Ivailo2707/Multiboard/README.md

# Multiboard
Multifunctional PCB with microcontroller and FPGA for embedded systems development
