Ivailo2707/Multiboard/Multiboard/Multiboard.kicad_pcb

## KiCad design Multiboard/Multiboard.kicad_pcb (2026-04-07)

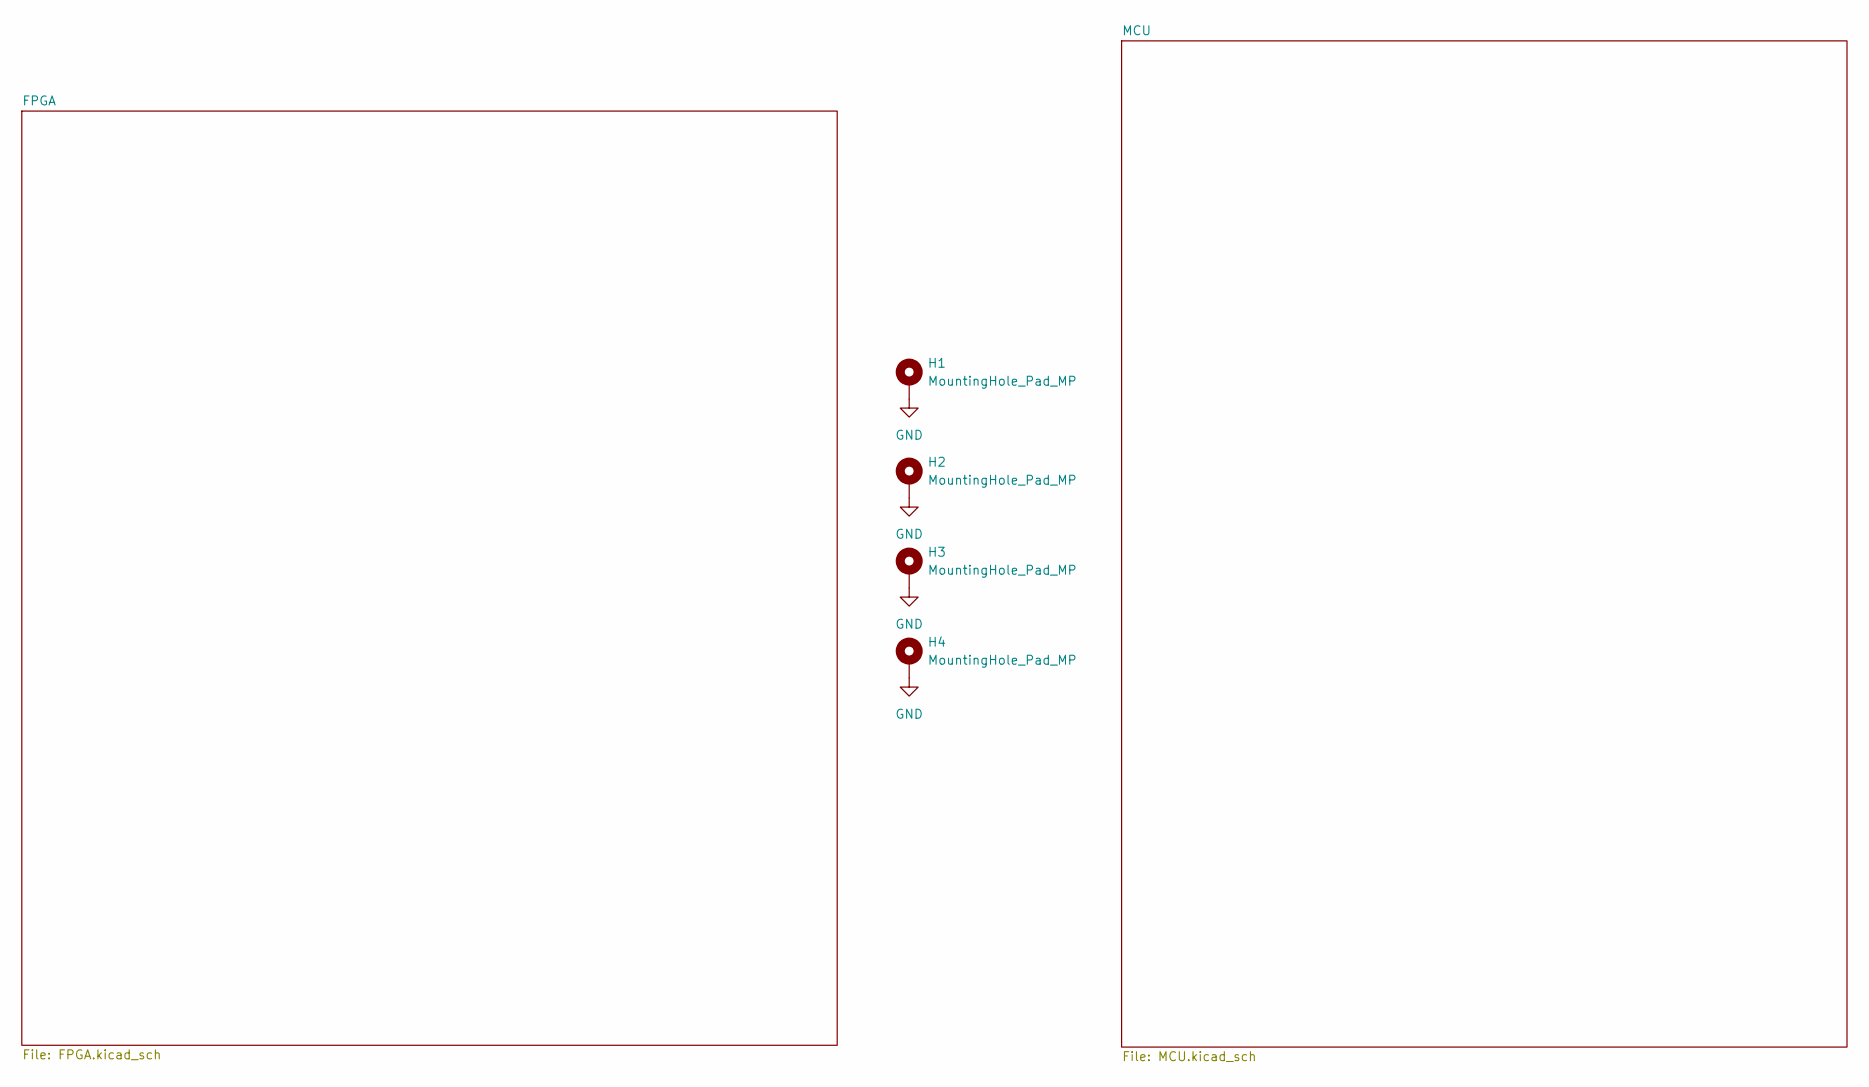
[picture p1: schematic Multiboard.kicad_sch, IR-Multiboard]

Parts:
H1, H2, H3, H4: MountingHole_Pad_MP; MountingHole_3.2mm_M3_DIN965_Pad_TopBottom

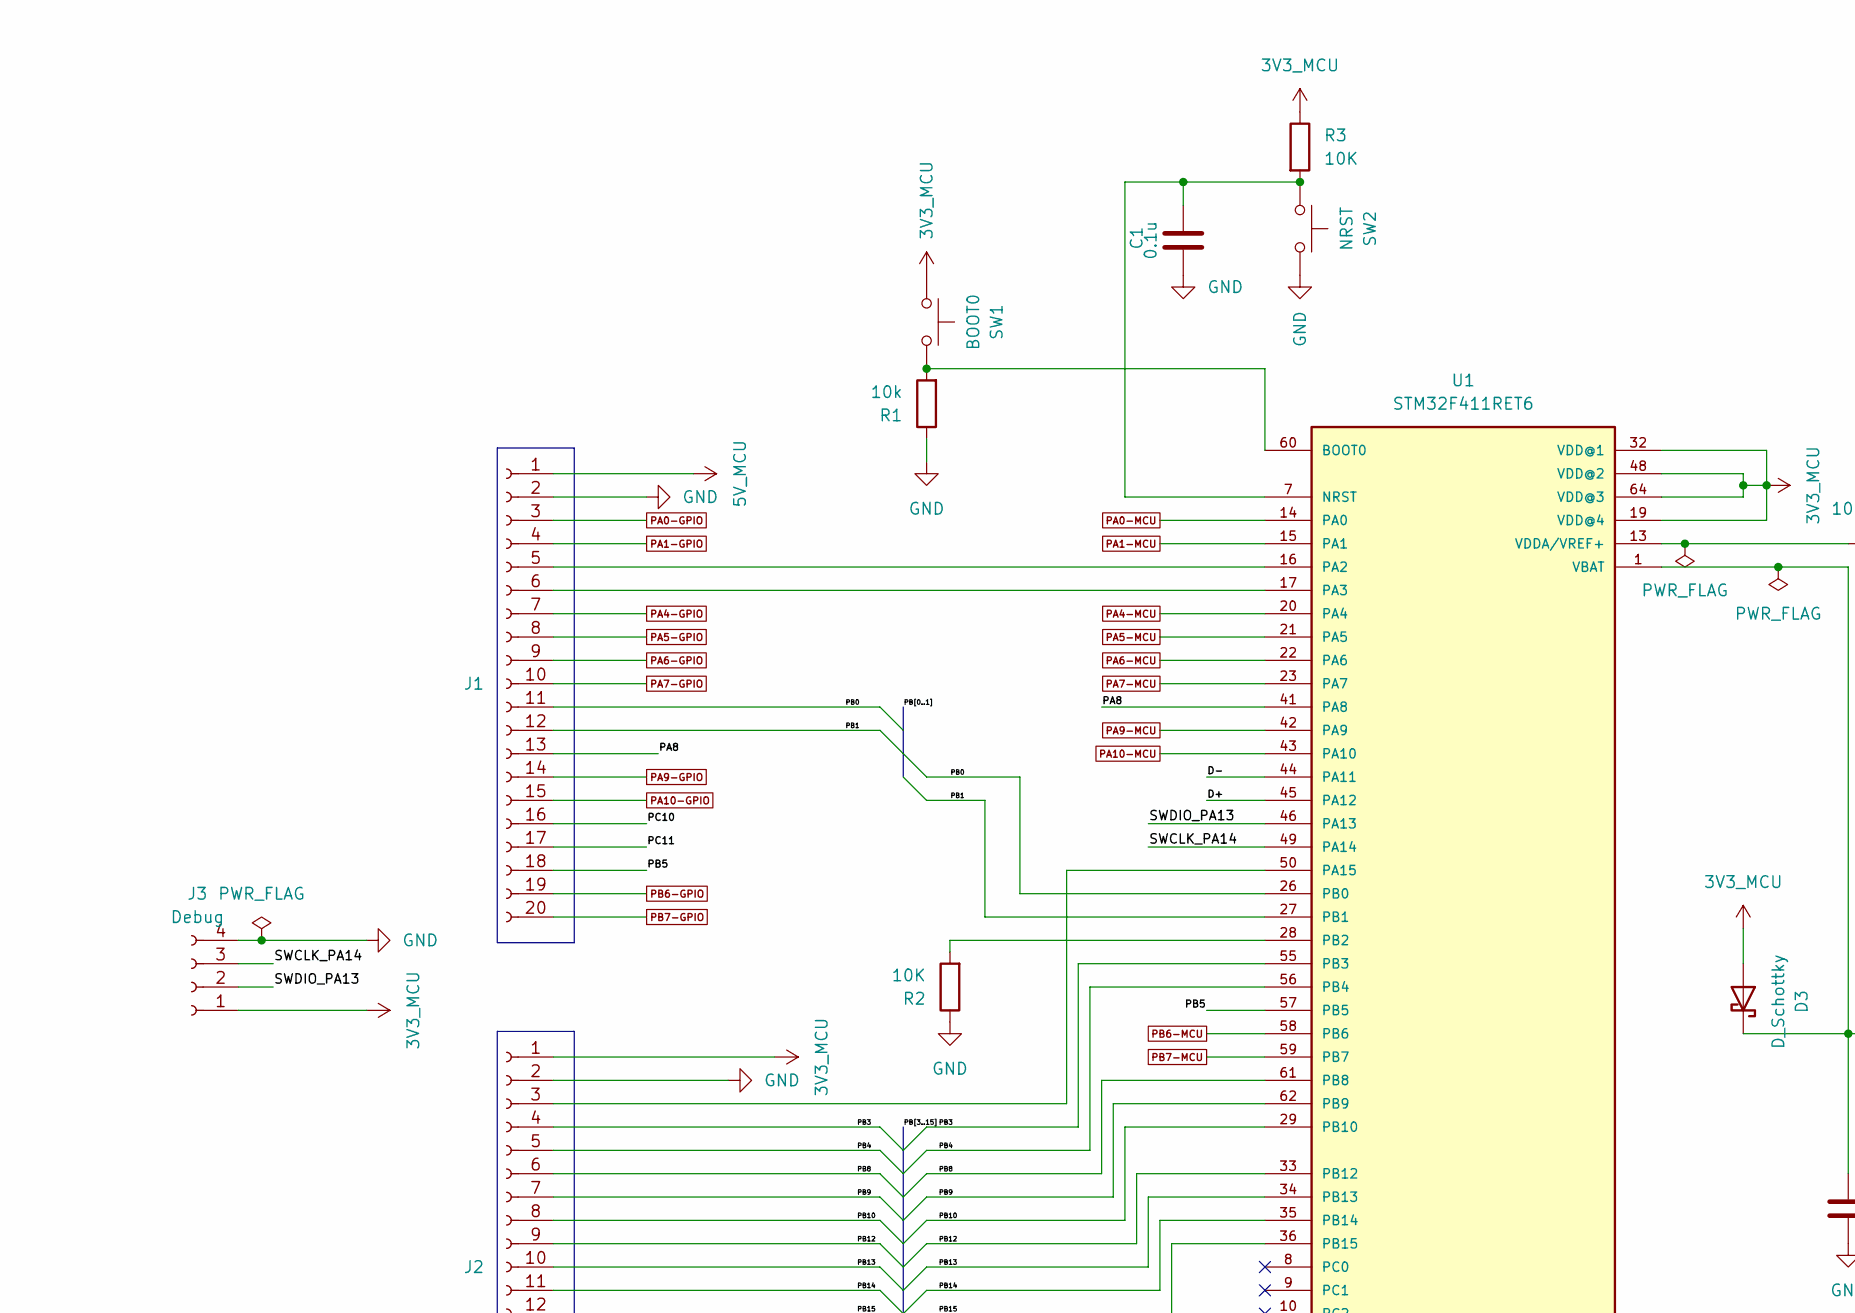
[picture p2: schematic MCU.kicad_sch, part in row 1, column 1]

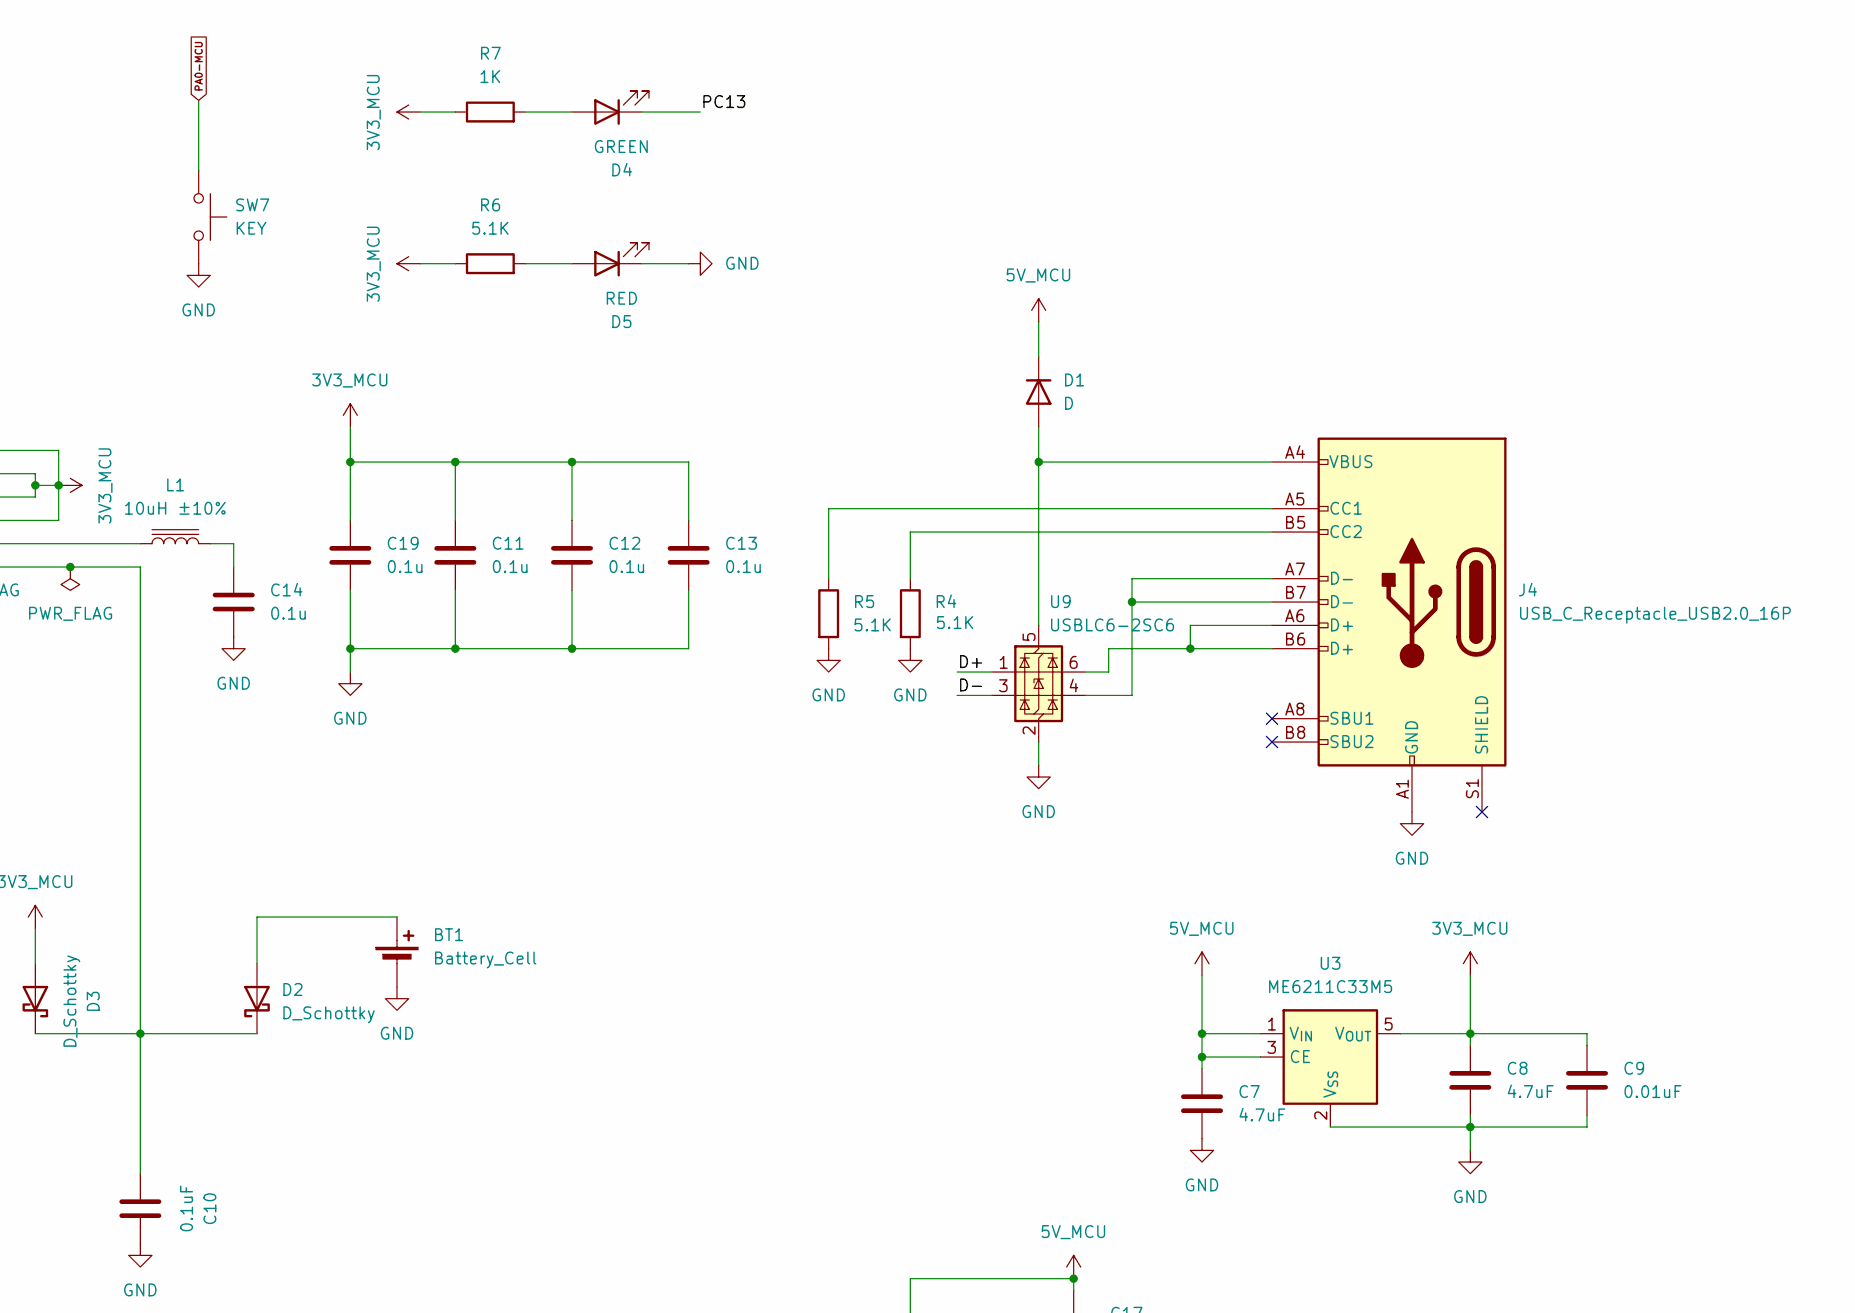
[picture p3: schematic MCU.kicad_sch, part in row 1, column 2]

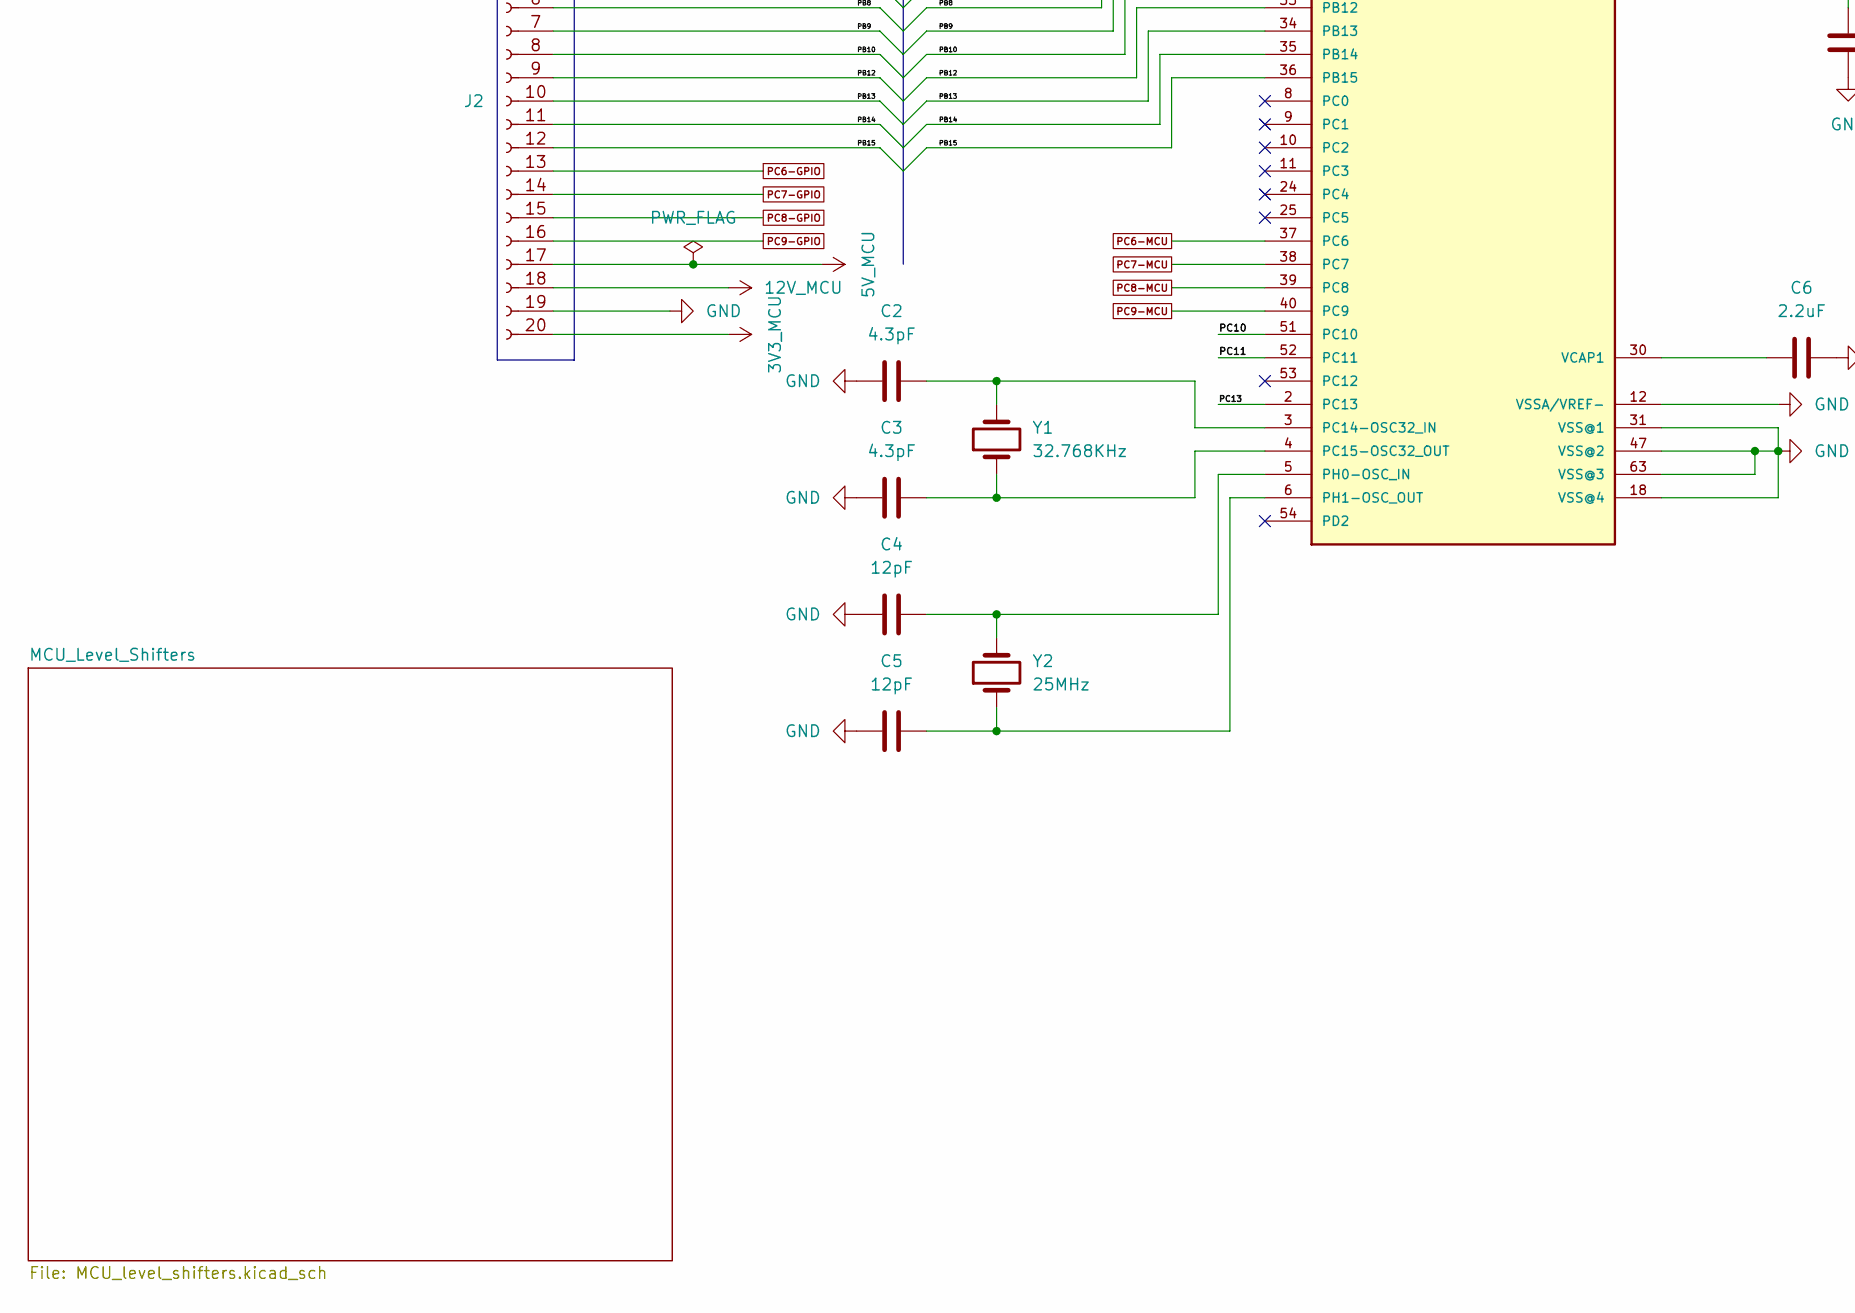
[picture p4: schematic MCU.kicad_sch, part in row 2, column 1]

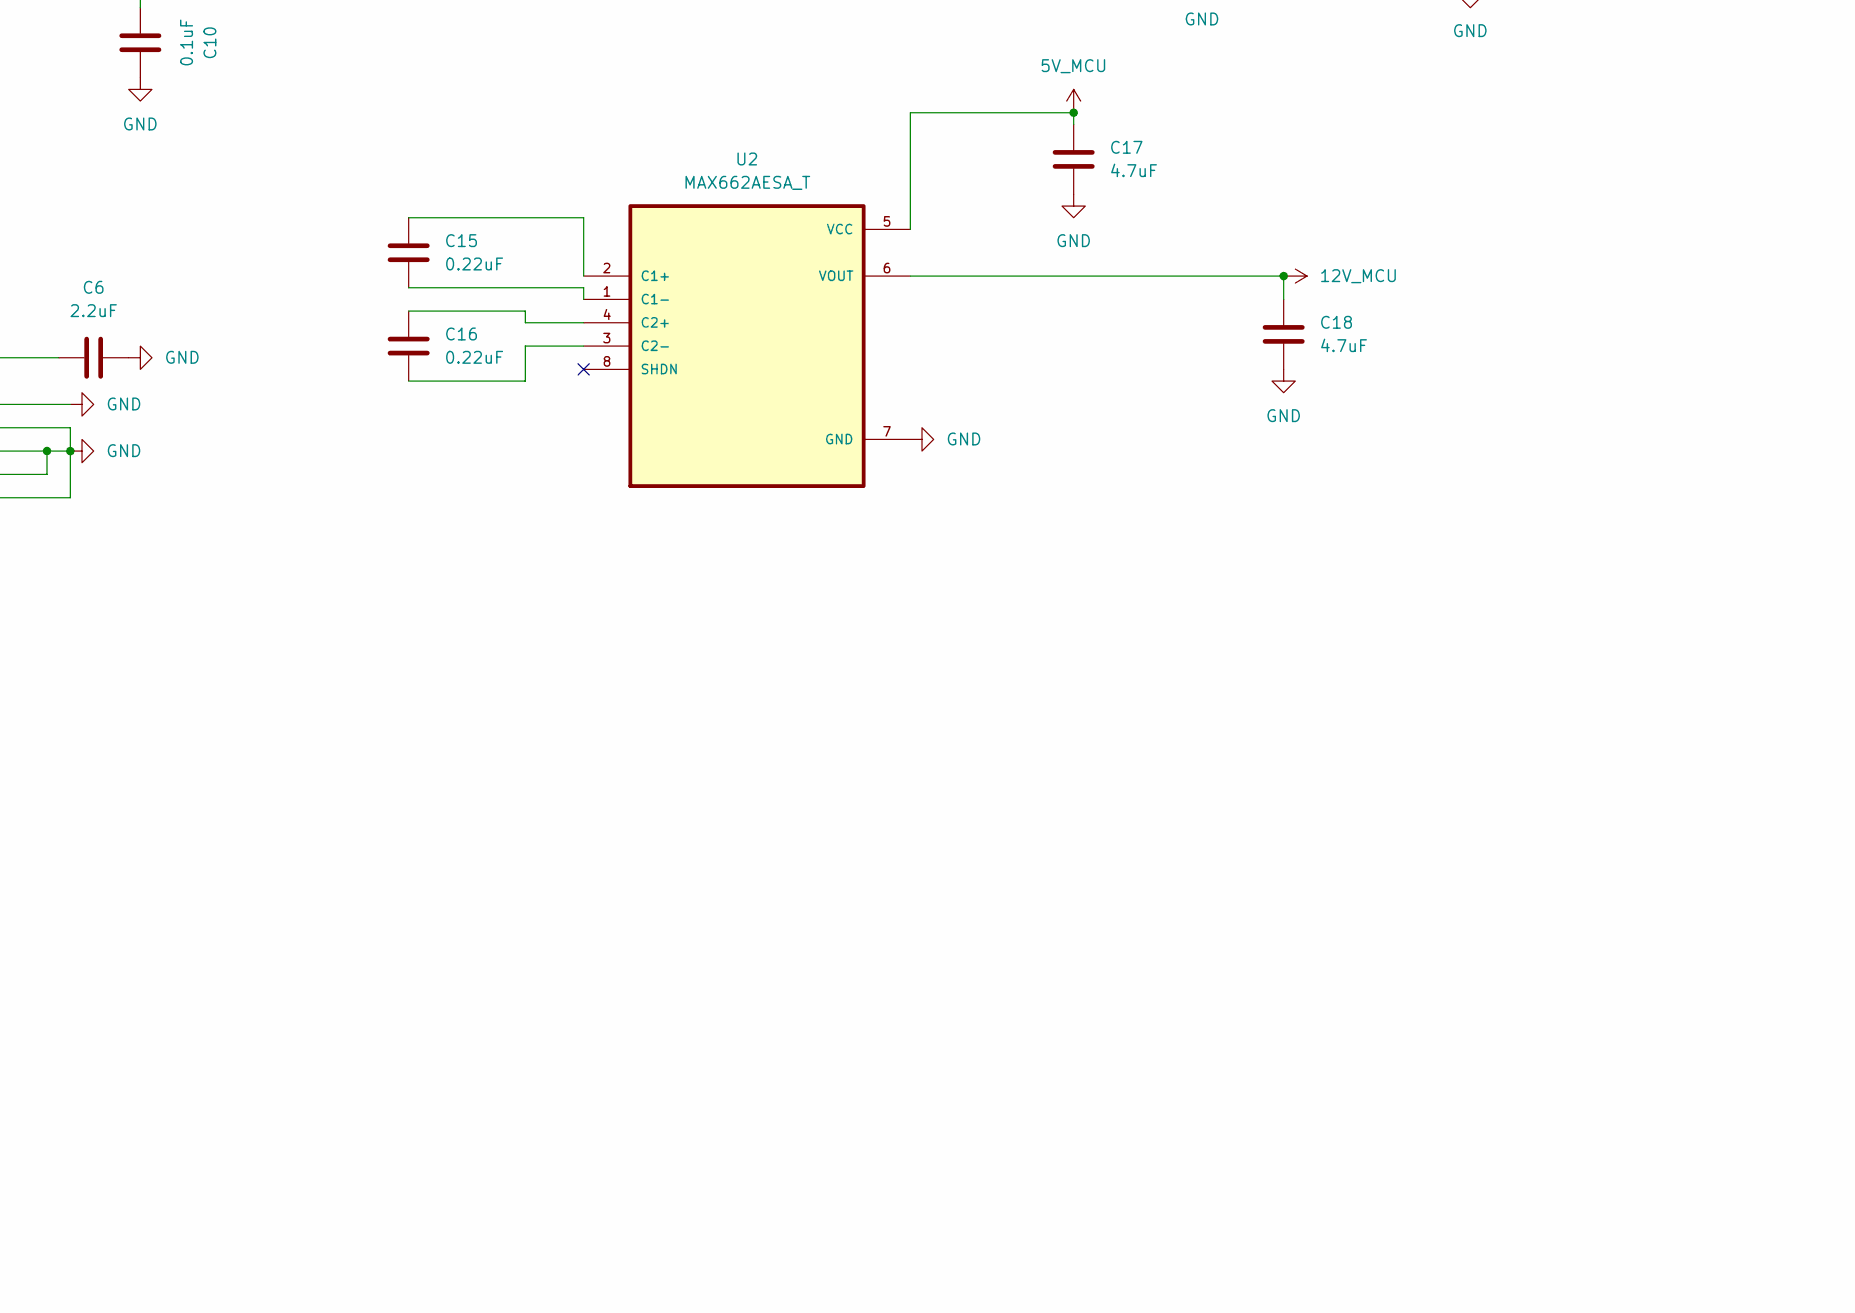
[picture p5: schematic MCU.kicad_sch, part in row 2, column 2]

Parts:
BT1: Battery_Cell; Battery_Panasonic_CR2032-VS1N_Vertical_CircularHoles
C1, C11, C12, C13, C14, C19: 0.1u; C_0603_1608Metric_Pad1.08x0.95mm_HandSolder; LCSC Part Number C14663
C2, C3: 4.3pF; C_0603_1608Metric_Pad1.08x0.95mm_HandSolder; LCSC Part Number C519375
C4, C5: 12pF; C_0603_1608Metric_Pad1.08x0.95mm_HandSolder; LCSC Part Number C38523
C6: 2.2uF; C_0603_1608Metric_Pad1.08x0.95mm_HandSolder; LCSC Part Number C913904
C7, C8, C17: 4.7uF; C_0603_1608Metric_Pad1.08x0.95mm_HandSolder; LCSC Part Number C19666
C9: 0.01uF; C_0603_1608Metric_Pad1.08x0.95mm_HandSolder; LCSC Part Number C100042
C10: 0.1uF; C_0603_1608Metric_Pad1.08x0.95mm_HandSolder; LCSC Part Number C14663
C15, C16: 0.22uF; C_0603_1608Metric_Pad1.08x0.95mm_HandSolder; LCSC Part Number C64705
C18: 4.7uF; C_0603_1608Metric_Pad1.08x0.95mm_HandSolder; LCSC Part Number C161217
D1: D; D_0603_1608Metric_Pad1.05x0.95mm_HandSolder
D2, D3: D_Schottky; D_SOD-323F; LCSC Part Number C2903903
D4: GREEN; LED_0603_1608Metric_Pad1.05x0.95mm_HandSolder; LCSC Part Number C2994781
D5: RED; LED_0603_1608Metric_Pad1.05x0.95mm_HandSolder; LCSC Part Number C2846640
J1, J2: Conn_01x20_Socket; PinHeader_1x20_P2.54mm_Vertical
J3: Debug; Hirose_DF13-04P-1.25DSA_1x04_P1.25mm_Vertical
J4: USB_C_Receptacle_USB2.0_16P; USB_C_Receptacle_G-Switch_GT-USB-7010ASV; LCSC Part Number C2988369
L1: 10uH ±10%; L_0603_1608Metric_Pad1.05x0.95mm_HandSolder; LCSC Part Number C6808014
R1: 10k; R_0603_1608Metric_Pad0.98x0.95mm_HandSolder; LCSC Part Number C98220
R2, R3: 10K; R_0603_1608Metric_Pad0.98x0.95mm_HandSolder; LCSC Part Number C98220
R4, R5, R6: 5.1K; R_0603_1608Metric_Pad0.98x0.95mm_HandSolder; LCSC Part Number C2907044
R7: 1K; R_0603_1608Metric_Pad0.98x0.95mm_HandSolder; LCSC Part Number C22548
SW1: BOOT0; SW_PUSH_6mm; LCSC Part Number C7528752
SW2: NRST; SW_PUSH_6mm; LCSC Part Number C7528752
SW7: KEY; SW_PUSH_6mm; LCSC Part Number C7528752
U1: STM32F411RET6; QFP50P1200X1200X160-64N; LCSC Part Number C94355
U2: MAX662AESA_T; SOIC127P600X175-8N; LCSC Part Number C2976348
U3: ME6211C33M5; SOT-23-5_HandSoldering; LCSC Part Number C2984946
U9: USBLC6-2SC6; SOT-23-6; LCSC Part Number C7519
Y1: 32.768KHz; Crystal_SMD_3215-2Pin_3.2x1.5mm; LCSC Part Number C95361
Y2: 25MHz; Crystal_SMD_3225-4Pin_3.2x2.5mm; LCSC Part Number C255920

Connections:
3V3_MCU: C8.1, C9.1, C11.1, C12.1, C13.1, C19.1, D3.2 (A), J2.1, J2.20, J3.1, R3.1, R6.1, R7.1, SW1.1, U1.19 (VDD@4), U1.32 (VDD@1), U1.48 (VDD@2), U1.64 (VDD@3), U3.5 (V_{OUT}); also elsewhere on the board
5V_MCU: C7.1, C17.1, D1.1 (K), J1.1, J2.17, U2.5 (VCC), U3.1 (V_{IN}), U3.3 (CE); also elsewhere on the board
12V_MCU: C18.1, J2.18, U2.6 (VOUT)
/MCU/D+: U1.45 (PA12), U9.1 (I/O1)
/MCU/D-: U1.44 (PA11), U9.3 (I/O2)
/MCU/PA8: J1.13, U1.41 (PA8)
/MCU/PB0: J1.11, U1.26 (PB0)
/MCU/PB1: J1.12, U1.27 (PB1)
/MCU/PB3: J2.4, U1.55 (PB3)
/MCU/PB4: J2.5, U1.56 (PB4)
/MCU/PB5: J1.18, U1.57 (PB5)
/MCU/PB8: J2.6, U1.61 (PB8)
/MCU/PB9: J2.7, U1.62 (PB9)
/MCU/PB10: J2.8, U1.29 (PB10)
/MCU/PB12: J2.9, U1.33 (PB12)
/MCU/PB13: J2.10, U1.34 (PB13)
/MCU/PB14: J2.11, U1.35 (PB14)
/MCU/PB15: J2.12, U1.36 (PB15)
/MCU/PC10: J1.16, U1.51 (PC10)
/MCU/PC11: J1.17, U1.52 (PC11)
/MCU/PC13: D4.1 (K), U1.2 (PC13)
/MCU/SWCLK_PA14: J3.3, U1.49 (PA14)
/MCU/SWDIO_PA13: J3.2, U1.46 (PA13)
GND: BT1.2 (-), C1.2, C2.1, C3.1, C4.1, C5.1, C6.2, C7.2, C8.2, C9.2, C10.2, C11.2, C12.2, C13.2, C14.1, C17.2, C18.2, C19.2, D5.1 (K), J1.2, J2.2, J2.19, J3.4, J4.A1 (GND), J4.A12 (GND), J4.B1 (GND), J4.B12 (GND), R1.1, R2.1, R4.2, R5.2, SW2.2, SW7.2, U1.12 (VSSA/VREF-), U1.18 (VSS@4), U1.31 (VSS@1), U1.47 (VSS@2), U1.63 (VSS@3), U2.7 (GND), U3.2 (V_{SS}), U9.2 (GND); also elsewhere on the board
unnamed: C14.2, L1.2
unnamed: D1.2 (A), J4.A4 (VBUS), J4.A9 (VBUS), J4.B4 (VBUS), J4.B9 (VBUS), U9.5 (VBUS)
unnamed: C10.1, D2.1 (K), D3.1 (K), U1.1 (VBAT)
unnamed: D4.2 (A), R7.2
unnamed: D5.2 (A), R6.2
unnamed: J4.A5 (CC1), R5.1
unnamed: J4.B5 (CC2), R4.1
unnamed: J4.A6 (D+), J4.B6 (D+), U9.6 (I/O1)
unnamed: J4.A7 (D-), J4.B7 (D-), U9.4 (I/O2)
unnamed: R1.2, SW1.2, U1.60 (BOOT0)
unnamed: C1.1, R3.2, SW2.1, U1.7 (NRST)
unnamed: R2.2, U1.28 (PB2)
unnamed: C2.2, U1.3 (PC14-OSC32_IN), Y1.2
unnamed: C3.2, U1.4 (PC15-OSC32_OUT), Y1.1
unnamed: C4.2, U1.5 (PH0-OSC_IN), Y2.3
unnamed: C5.2, U1.6 (PH1-OSC_OUT), Y2.1
unnamed: C6.1, U1.30 (VCAP1)
unnamed: L1.1, U1.13 (VDDA/VREF+)
unnamed: C15.1, U2.2 (C1+)
unnamed: C15.2, U2.1 (C1-)
unnamed: C16.1, U2.4 (C2+)
unnamed: C16.2, U2.3 (C2-)
PA0-GPIO: J1.3; also elsewhere on the board
PA0-MCU: SW7.1, U1.14 (PA0); also elsewhere on the board
PA1-GPIO: J1.4; also elsewhere on the board
PA1-MCU: U1.15 (PA1); also elsewhere on the board
PA4-GPIO: J1.7; also elsewhere on the board
PA4-MCU: U1.20 (PA4); also elsewhere on the board
PA5-GPIO: J1.8; also elsewhere on the board
PA5-MCU: U1.21 (PA5); also elsewhere on the board
PA6-GPIO: J1.9; also elsewhere on the board
PA6-MCU: U1.22 (PA6); also elsewhere on the board
PA7-GPIO: J1.10; also elsewhere on the board
PA7-MCU: U1.23 (PA7); also elsewhere on the board
PA9-GPIO: J1.14; also elsewhere on the board
PA9-MCU: U1.42 (PA9); also elsewhere on the board
PA10-GPIO: J1.15; also elsewhere on the board
PA10-MCU: U1.43 (PA10); also elsewhere on the board
PB6-GPIO: J1.19; also elsewhere on the board
PB6-MCU: U1.58 (PB6); also elsewhere on the board
PB7-GPIO: J1.20; also elsewhere on the board
PB7-MCU: U1.59 (PB7); also elsewhere on the board
PC6-GPIO: J2.13; also elsewhere on the board
PC6-MCU: U1.37 (PC6); also elsewhere on the board
PC7-GPIO: J2.14; also elsewhere on the board
PC7-MCU: U1.38 (PC7); also elsewhere on the board
PC8-GPIO: J2.15; also elsewhere on the board
PC8-MCU: U1.39 (PC8); also elsewhere on the board
PC9-GPIO: J2.16; also elsewhere on the board
PC9-MCU: U1.40 (PC9); also elsewhere on the board
