Ivailo2707/Multiboard/Multiboard/Multiboard.kicad_pcb

## KiCad design Multiboard/Multiboard.kicad_pcb (continued)

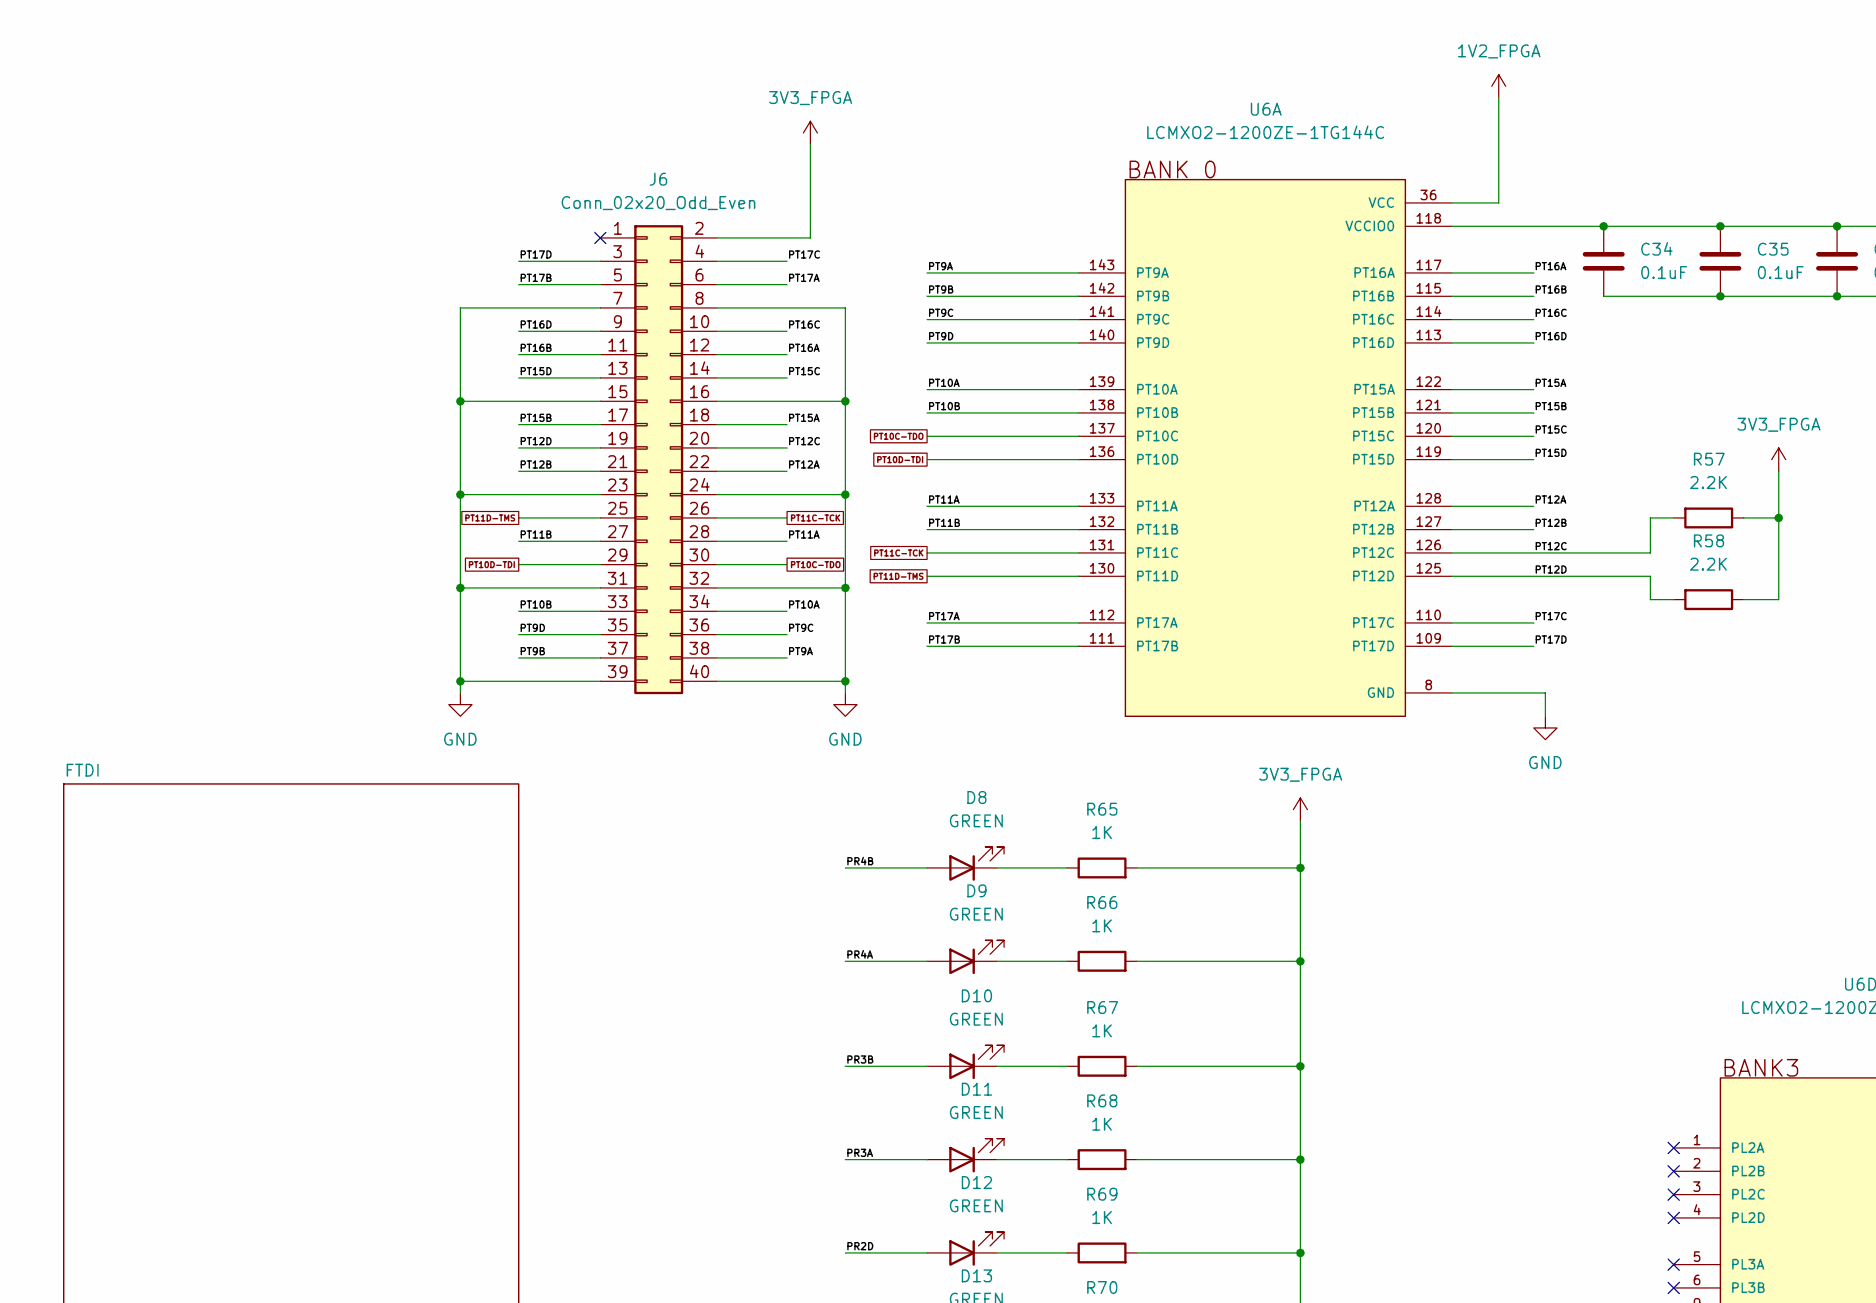
[picture p6: schematic FPGA.kicad_sch, part in row 1, column 1]

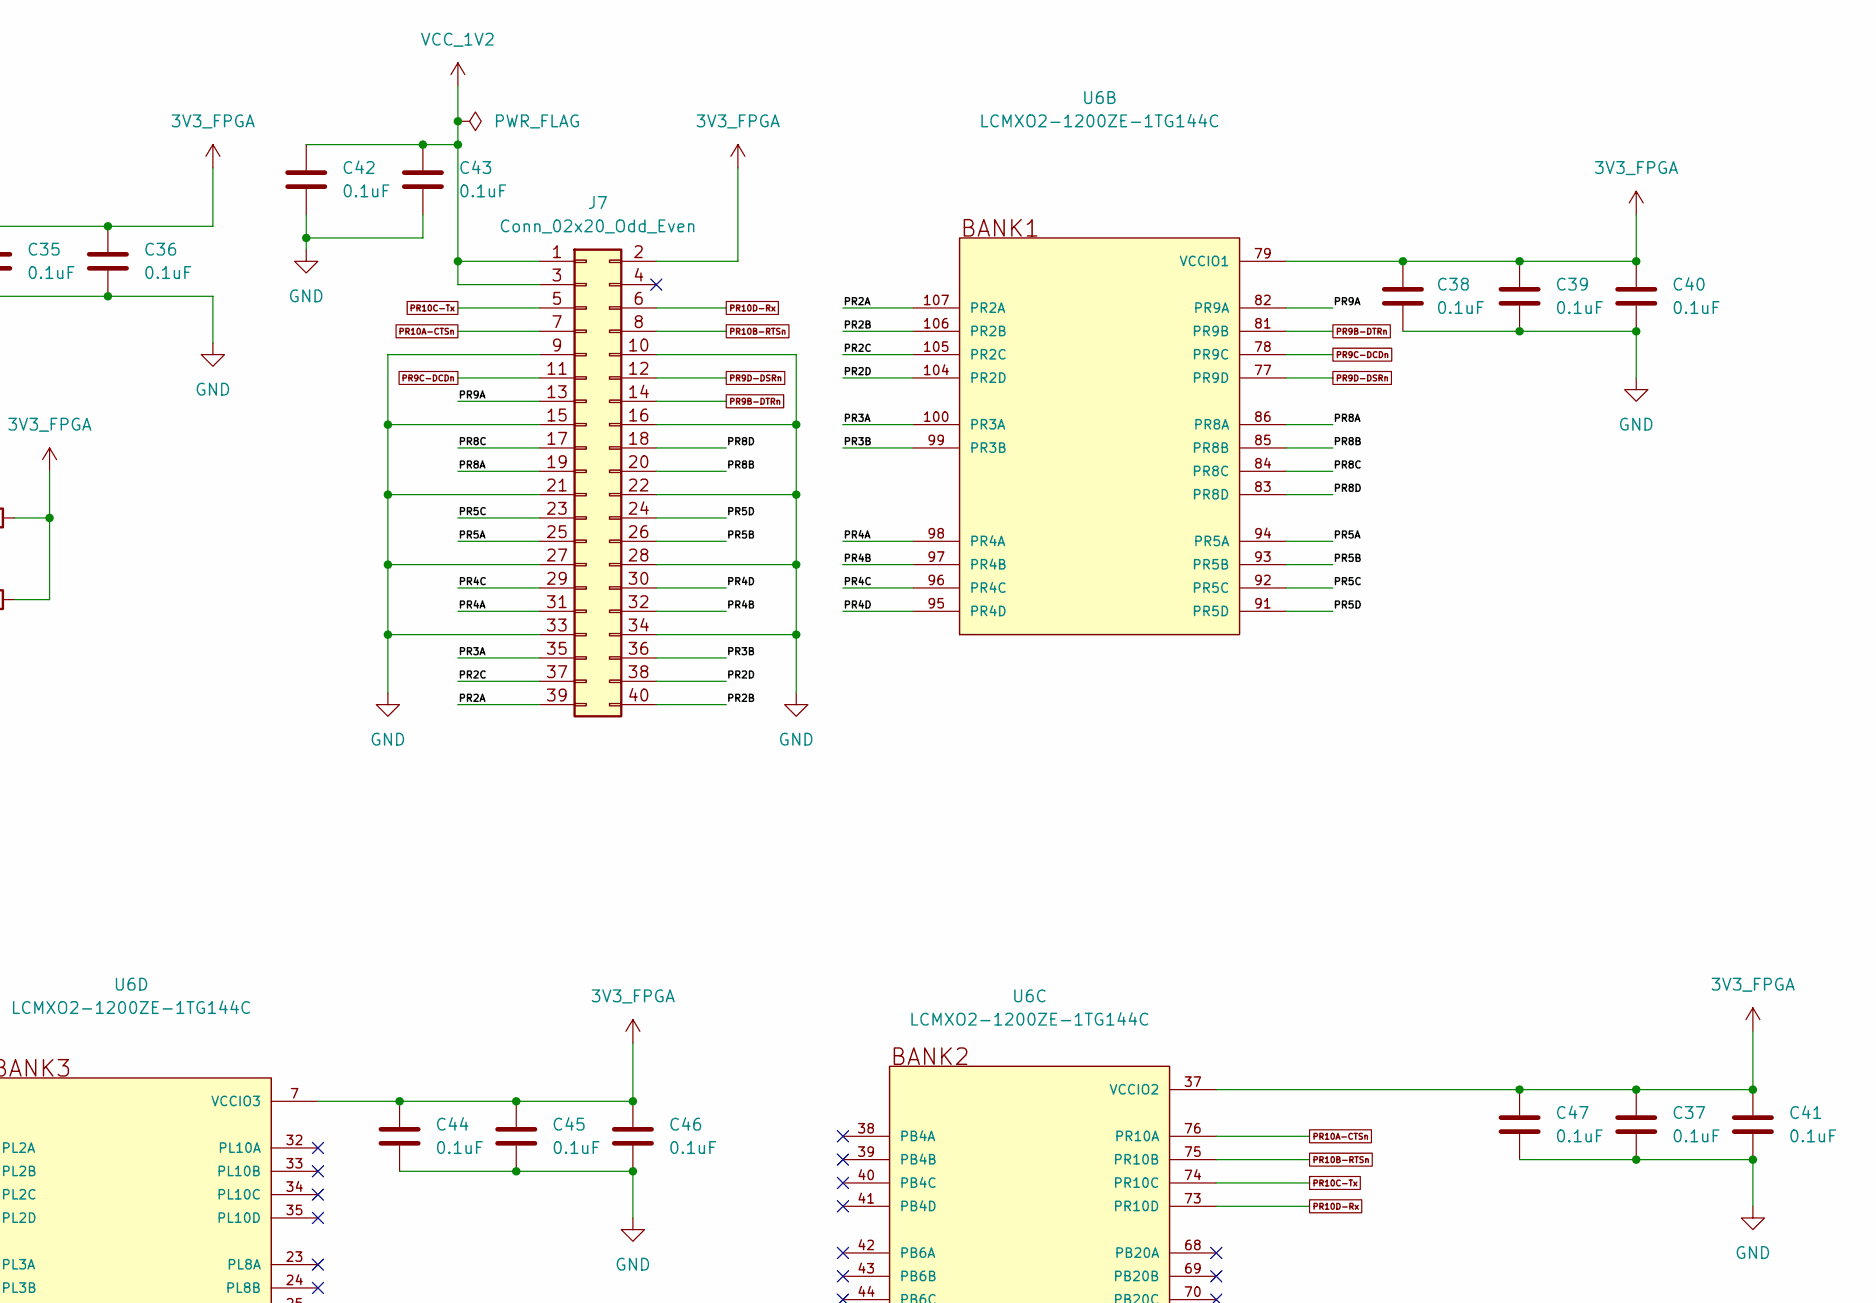
[picture p7: schematic FPGA.kicad_sch, part in row 1, column 2]

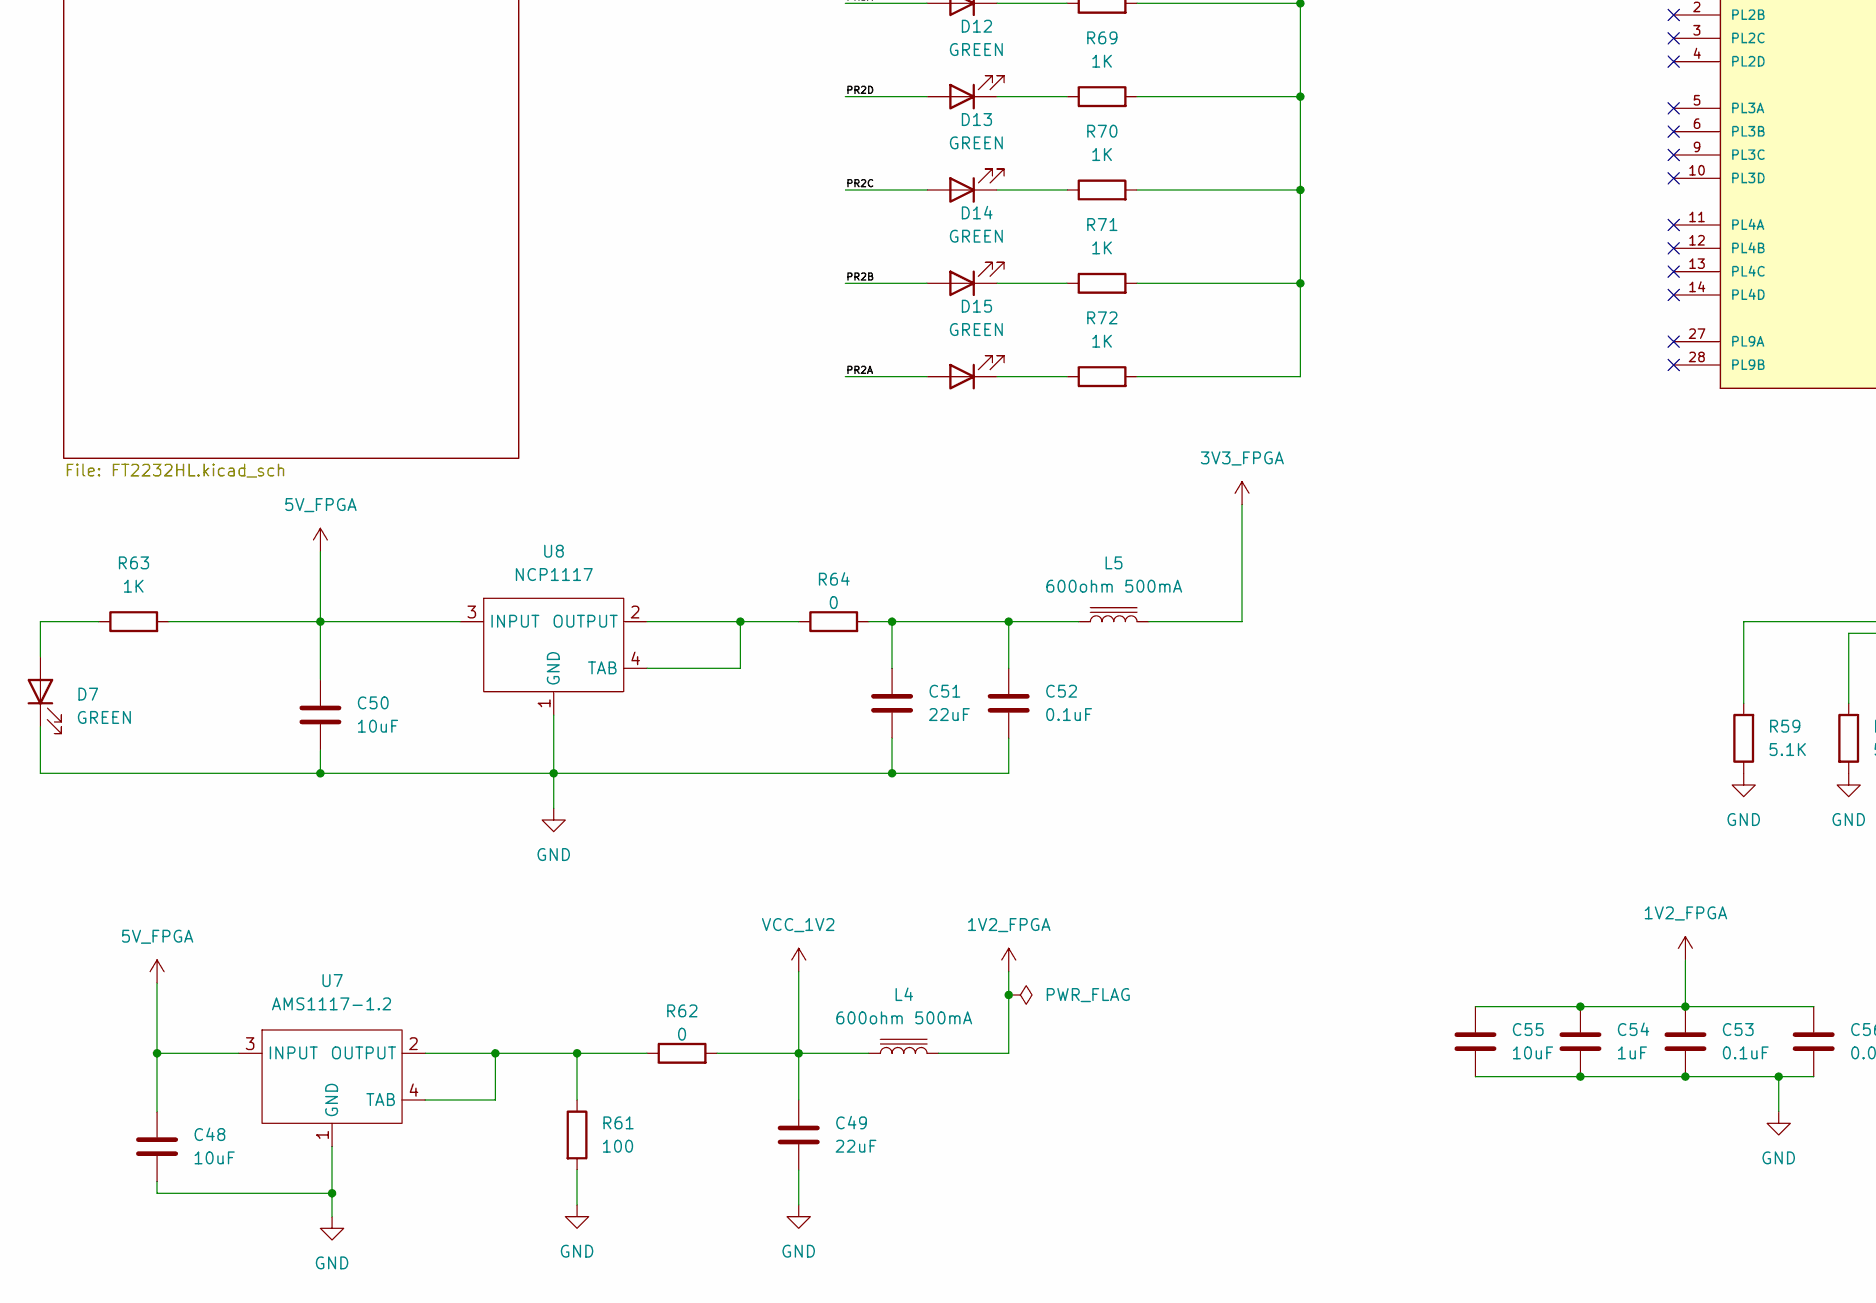
[picture p8: schematic FPGA.kicad_sch, part in row 2, column 1]

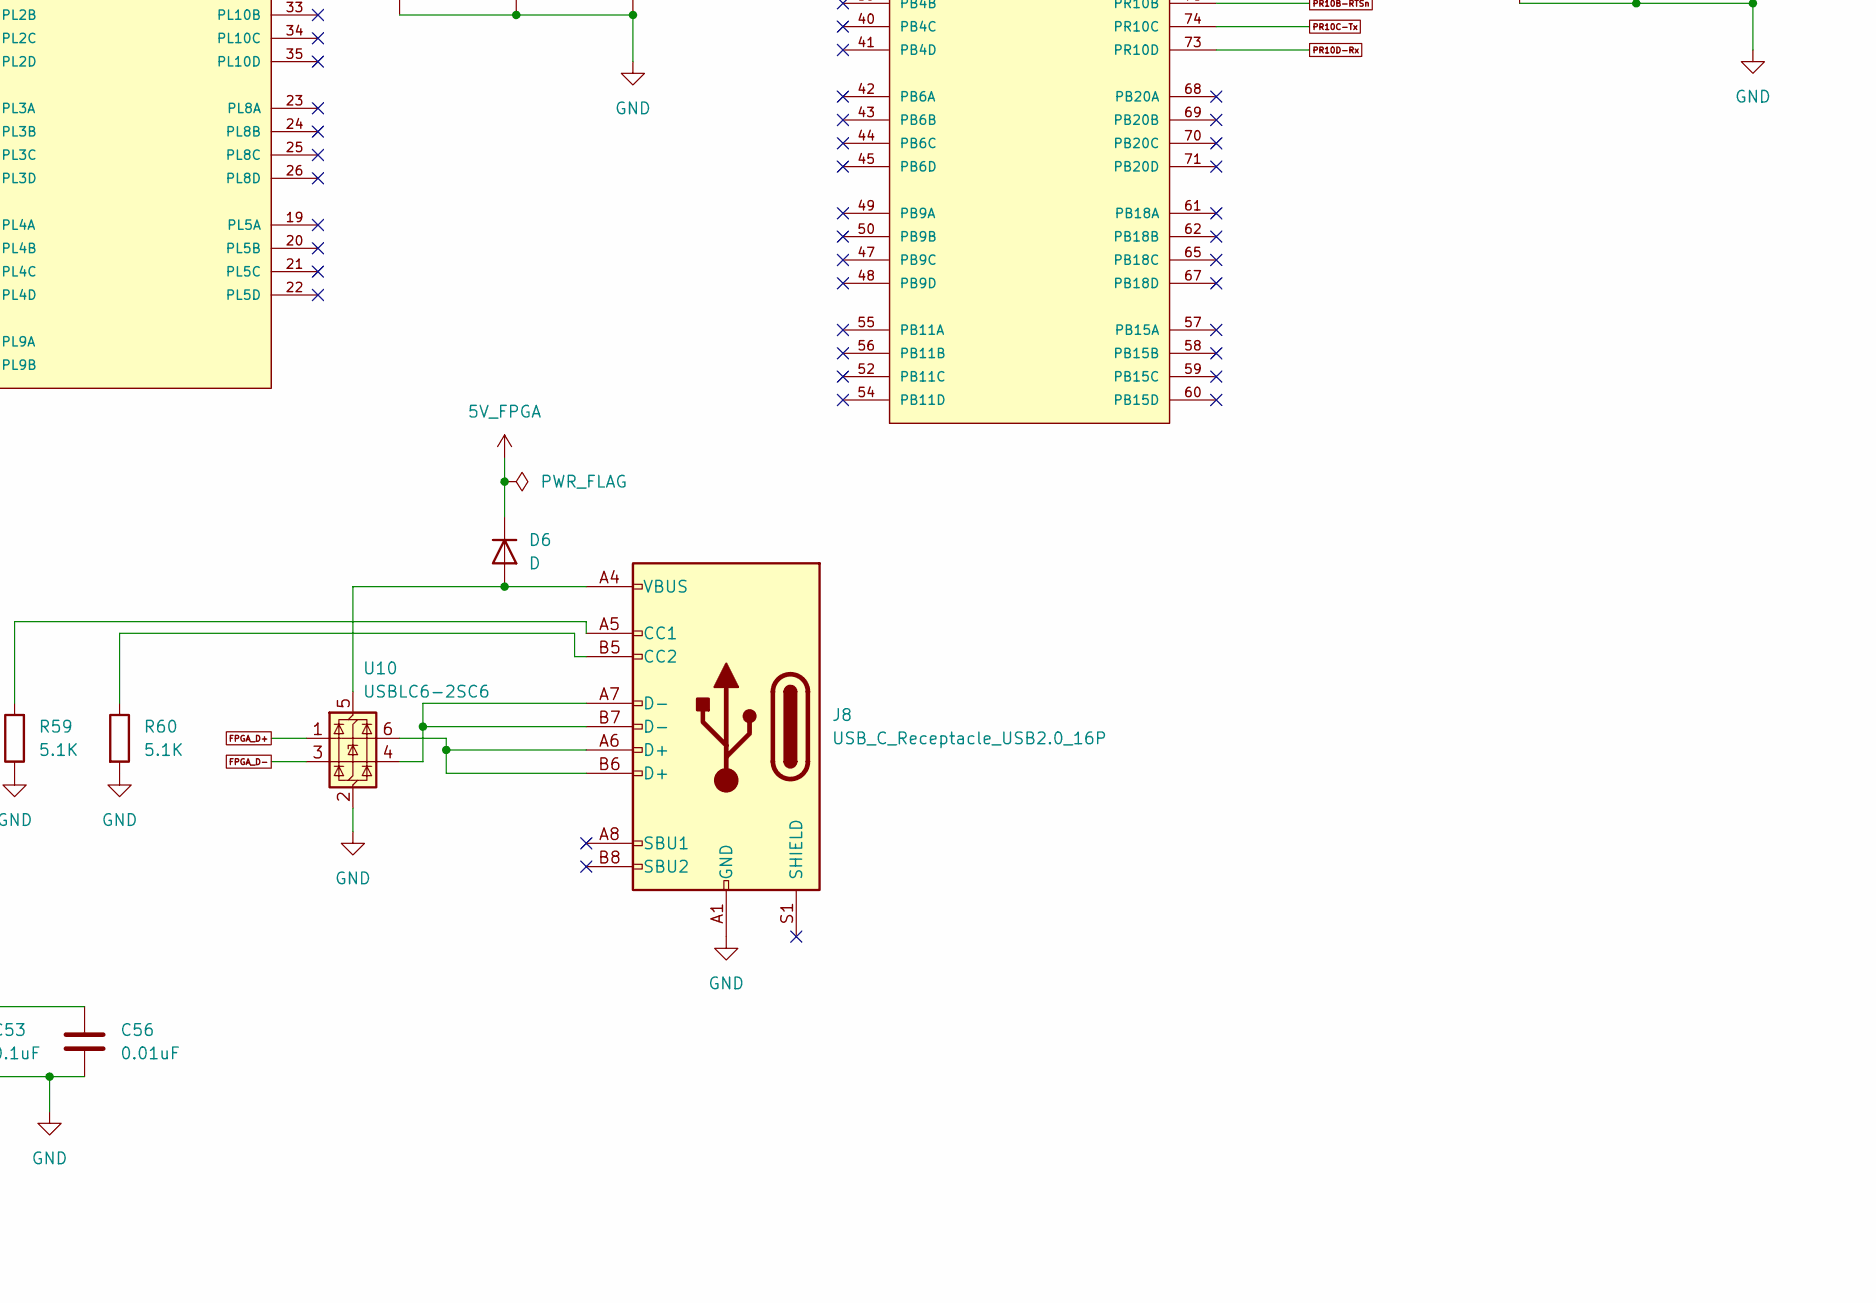
[picture p9: schematic FPGA.kicad_sch, part in row 2, column 2]

Parts:
C34, C35, C36, C37, C38, C39, C40, C41, C42, C43, C44, C45, C46, C47, C52, C53: 0.1uF; C_0603_1608Metric_Pad1.08x0.95mm_HandSolder; LCSC Part Number C14663
C48, C50, C55: 10uF; C_0603_1608Metric_Pad1.08x0.95mm_HandSolder; LCSC Part Number C19702
C49, C51: 22uF; C_0603_1608Metric_Pad1.08x0.95mm_HandSolder; LCSC Part Number C86295
C54: 1uF; C_0603_1608Metric_Pad1.08x0.95mm_HandSolder; LCSC Part Number C95843
C56: 0.01uF; C_0603_1608Metric_Pad1.08x0.95mm_HandSolder; LCSC Part Number C100042
D6: D; D_0603_1608Metric_Pad1.05x0.95mm_HandSolder
D7, D8, D9, D10, D11, D12, D13, D14, D15: GREEN; LED_0603_1608Metric_Pad1.05x0.95mm_HandSolder; LCSC Part Number C2994781
J6, J7: Conn_02x20_Odd_Even; PinHeader_2x20_P2.54mm_Vertical
J8: USB_C_Receptacle_USB2.0_16P; USB_C_Receptacle_G-Switch_GT-USB-7010ASV; LCSC Part Number C2988369
L4, L5: 600ohm 500mA; L_0603_1608Metric_Pad1.05x0.95mm_HandSolder; LCSC Part Number C20345
R57, R58: 2.2K; R_0603_1608Metric_Pad0.98x0.95mm_HandSolder; LCSC Part Number C114662
R59, R60: 5.1K; R_0603_1608Metric_Pad0.98x0.95mm_HandSolder; LCSC Part Number C2907044
R61: 100; R_0603_1608Metric_Pad0.98x0.95mm_HandSolder; LCSC Part Number C105588
R62, R64: 0; R_0603_1608Metric_Pad0.98x0.95mm_HandSolder; LCSC Part Number C95177
R63, R65, R66, R67, R68, R69, R70, R71, R72: 1K; R_0603_1608Metric_Pad0.98x0.95mm_HandSolder; LCSC Part Number C22548
U6: LCMXO2-1200ZE-1TG144C; QFP50P2200X2200X160-144N
U7: AMS1117-1.2; SOT-223; LCSC Part Number C14529
U8: NCP1117; SOT-223; LCSC Part Number C20546
U10: USBLC6-2SC6; SOT-23-6; LCSC Part Number C7519

Connections:
1V2_FPGA: C53.1, C54.1, C55.1, C56.1, L4.2, U6.36 (VCC), U6.72 (VCC), U6.108 (VCC), U6.144 (VCC)
3V3_FPGA: C34.1, C35.1, C36.1, C37.1, C38.1, C39.1, C40.1, C41.1, C44.1, C45.1, C46.1, C47.1, J6.2, J7.2, L5.2, R57.1, R58.1, R65.2, R66.2, R67.2, R68.2, R69.2, R70.2, R71.2, R72.2, U6.7 (VCCIO3), U6.16 (VCCIO3), U6.30 (VCCIO3), U6.37 (VCCIO2), U6.51 (VCCIO2), U6.66 (VCCIO2), U6.79 (VCCIO1), U6.88 (VCCIO1), U6.102 (VCCIO1), U6.118 (VCCIO0), U6.123 (VCCIO0), U6.135 (VCCIO0); also elsewhere on the board
5V_FPGA: C48.1, C50.1, D6.1 (K), R63.2, U7.3 (INPUT), U8.3 (INPUT)
/FPGA/PR2A: D15.2 (A), J7.39, U6.107 (PR2A)
/FPGA/PR2B: D14.2 (A), J7.40, U6.106 (PR2B)
/FPGA/PR2C: D13.2 (A), J7.37, U6.105 (PR2C)
/FPGA/PR2D: D12.2 (A), J7.38, U6.104 (PR2D)
/FPGA/PR3A: D11.2 (A), J7.35, U6.100 (PR3A)
/FPGA/PR3B: D10.2 (A), J7.36, U6.99 (PR3B)
/FPGA/PR4A: D9.2 (A), J7.31, U6.98 (PR4A)
/FPGA/PR4B: D8.2 (A), J7.32, U6.97 (PR4B)
/FPGA/PR4C: J7.29, U6.96 (PR4C)
/FPGA/PR4D: J7.30, U6.95 (PR4D)
/FPGA/PR5A: J7.25, U6.94 (PR5A)
/FPGA/PR5B: J7.26, U6.93 (PR5B)
/FPGA/PR5C: J7.23, U6.92 (PR5C)
/FPGA/PR5D: J7.24, U6.91 (PR5D)
/FPGA/PR8A: J7.19, U6.86 (PR8A)
/FPGA/PR8B: J7.20, U6.85 (PR8B)
/FPGA/PR8C: J7.17, U6.84 (PR8C)
/FPGA/PR8D: J7.18, U6.83 (PR8D)
/FPGA/PR9A: J7.13, U6.82 (PR9A)
/FPGA/PT9A: J6.38, U6.143 (PT9A)
/FPGA/PT9B: J6.37, U6.142 (PT9B)
/FPGA/PT9C: J6.36, U6.141 (PT9C)
/FPGA/PT9D: J6.35, U6.140 (PT9D)
/FPGA/PT10A: J6.34, U6.139 (PT10A)
/FPGA/PT10B: J6.33, U6.138 (PT10B)
/FPGA/PT11A: J6.28, U6.133 (PT11A)
/FPGA/PT11B: J6.27, U6.132 (PT11B)
/FPGA/PT12A: J6.22, U6.128 (PT12A)
/FPGA/PT12B: J6.21, U6.127 (PT12B)
/FPGA/PT12C: J6.20, R57.2, U6.126 (PT12C)
/FPGA/PT12D: J6.19, R58.2, U6.125 (PT12D)
/FPGA/PT15A: J6.18, U6.122 (PT15A)
/FPGA/PT15B: J6.17, U6.121 (PT15B)
/FPGA/PT15C: J6.14, U6.120 (PT15C)
/FPGA/PT15D: J6.13, U6.119 (PT15D)
/FPGA/PT16A: J6.12, U6.117 (PT16A)
/FPGA/PT16B: J6.11, U6.115 (PT16B)
/FPGA/PT16C: J6.10, U6.114 (PT16C)
/FPGA/PT16D: J6.9, U6.113 (PT16D)
/FPGA/PT17A: J6.6, U6.112 (PT17A)
/FPGA/PT17B: J6.5, U6.111 (PT17B)
/FPGA/PT17C: J6.4, U6.110 (PT17C)
/FPGA/PT17D: J6.3, U6.109 (PT17D)
FPGA_D+: U10.1 (I/O1); also elsewhere on the board
FPGA_D-: U10.3 (I/O2); also elsewhere on the board
GND: C34.2, C35.2, C36.2, C37.2, C38.2, C39.2, C40.2, C41.2, C42.2, C43.2, C44.2, C45.2, C46.2, C47.2, C48.2, C49.2, C50.2, C51.2, C52.2, C53.2, C54.2, C55.2, C56.2, D7.1 (K), J6.7, J6.8, J6.15, J6.16, J6.23, J6.24, J6.31, J6.32, J6.39, J6.40, J7.9, J7.10, J7.15, J7.16, J7.21, J7.22, J7.27, J7.28, J7.33, J7.34, J8.A1 (GND), J8.A12 (GND), J8.B1 (GND), J8.B12 (GND), R59.1, R60.2, R61.2, U6.8 (GND), U6.18 (GND), U6.29 (GND), U6.46 (GND), U6.53 (GND), U6.64 (GND), U6.80 (GND), U6.89 (GND), U6.90 (GND), U6.101 (GND), U6.116 (GND), U6.124 (GND), U6.134 (GND), U7.1 (GND), U8.1 (GND), U10.2 (GND); also elsewhere on the board
unnamed: C51.1, C52.1, L5.1, R64.2
unnamed: D6.2 (A), J8.A4 (VBUS), J8.A9 (VBUS), J8.B4 (VBUS), J8.B9 (VBUS), U10.5 (VBUS)
unnamed: D7.2 (A), R63.1
unnamed: D8.1 (K), R65.1
unnamed: D9.1 (K), R66.1
unnamed: D10.1 (K), R67.1
unnamed: D11.1 (K), R68.1
unnamed: D12.1 (K), R69.1
unnamed: D13.1 (K), R70.1
unnamed: D14.1 (K), R71.1
unnamed: D15.1 (K), R72.1
unnamed: J8.A5 (CC1), R59.2
unnamed: J8.B5 (CC2), R60.1
unnamed: J8.A6 (D+), J8.B6 (D+), U10.6 (I/O1)
unnamed: J8.A7 (D-), J8.B7 (D-), U10.4 (I/O2)
unnamed: R61.1, R62.1, U7.2 (OUTPUT), U7.4 (TAB)
unnamed: R64.1, U8.2 (OUTPUT), U8.4 (TAB)
PR9B-DTRn: J7.14, U6.81 (PR9B); also elsewhere on the board
PR9C-DCDn: J7.11, U6.78 (PR9C); also elsewhere on the board
PR9D-DSRn: J7.12, U6.77 (PR9D); also elsewhere on the board
PR10A-CTSn: J7.7, U6.76 (PR10A); also elsewhere on the board
PR10B-RTSn: J7.8, U6.75 (PR10B); also elsewhere on the board
PR10C-Tx: J7.5, U6.74 (PR10C); also elsewhere on the board
PR10D-Rx: J7.6, U6.73 (PR10D); also elsewhere on the board
PT10C-TDO: J6.30, U6.137 (PT10C); also elsewhere on the board
PT10D-TDI: J6.29, U6.136 (PT10D); also elsewhere on the board
PT11C-TCK: J6.26, U6.131 (PT11C); also elsewhere on the board
PT11D-TMS: J6.25, U6.130 (PT11D); also elsewhere on the board
VCC_1V2: C42.1, C43.1, C49.1, J7.1, J7.3, L4.1, R62.2

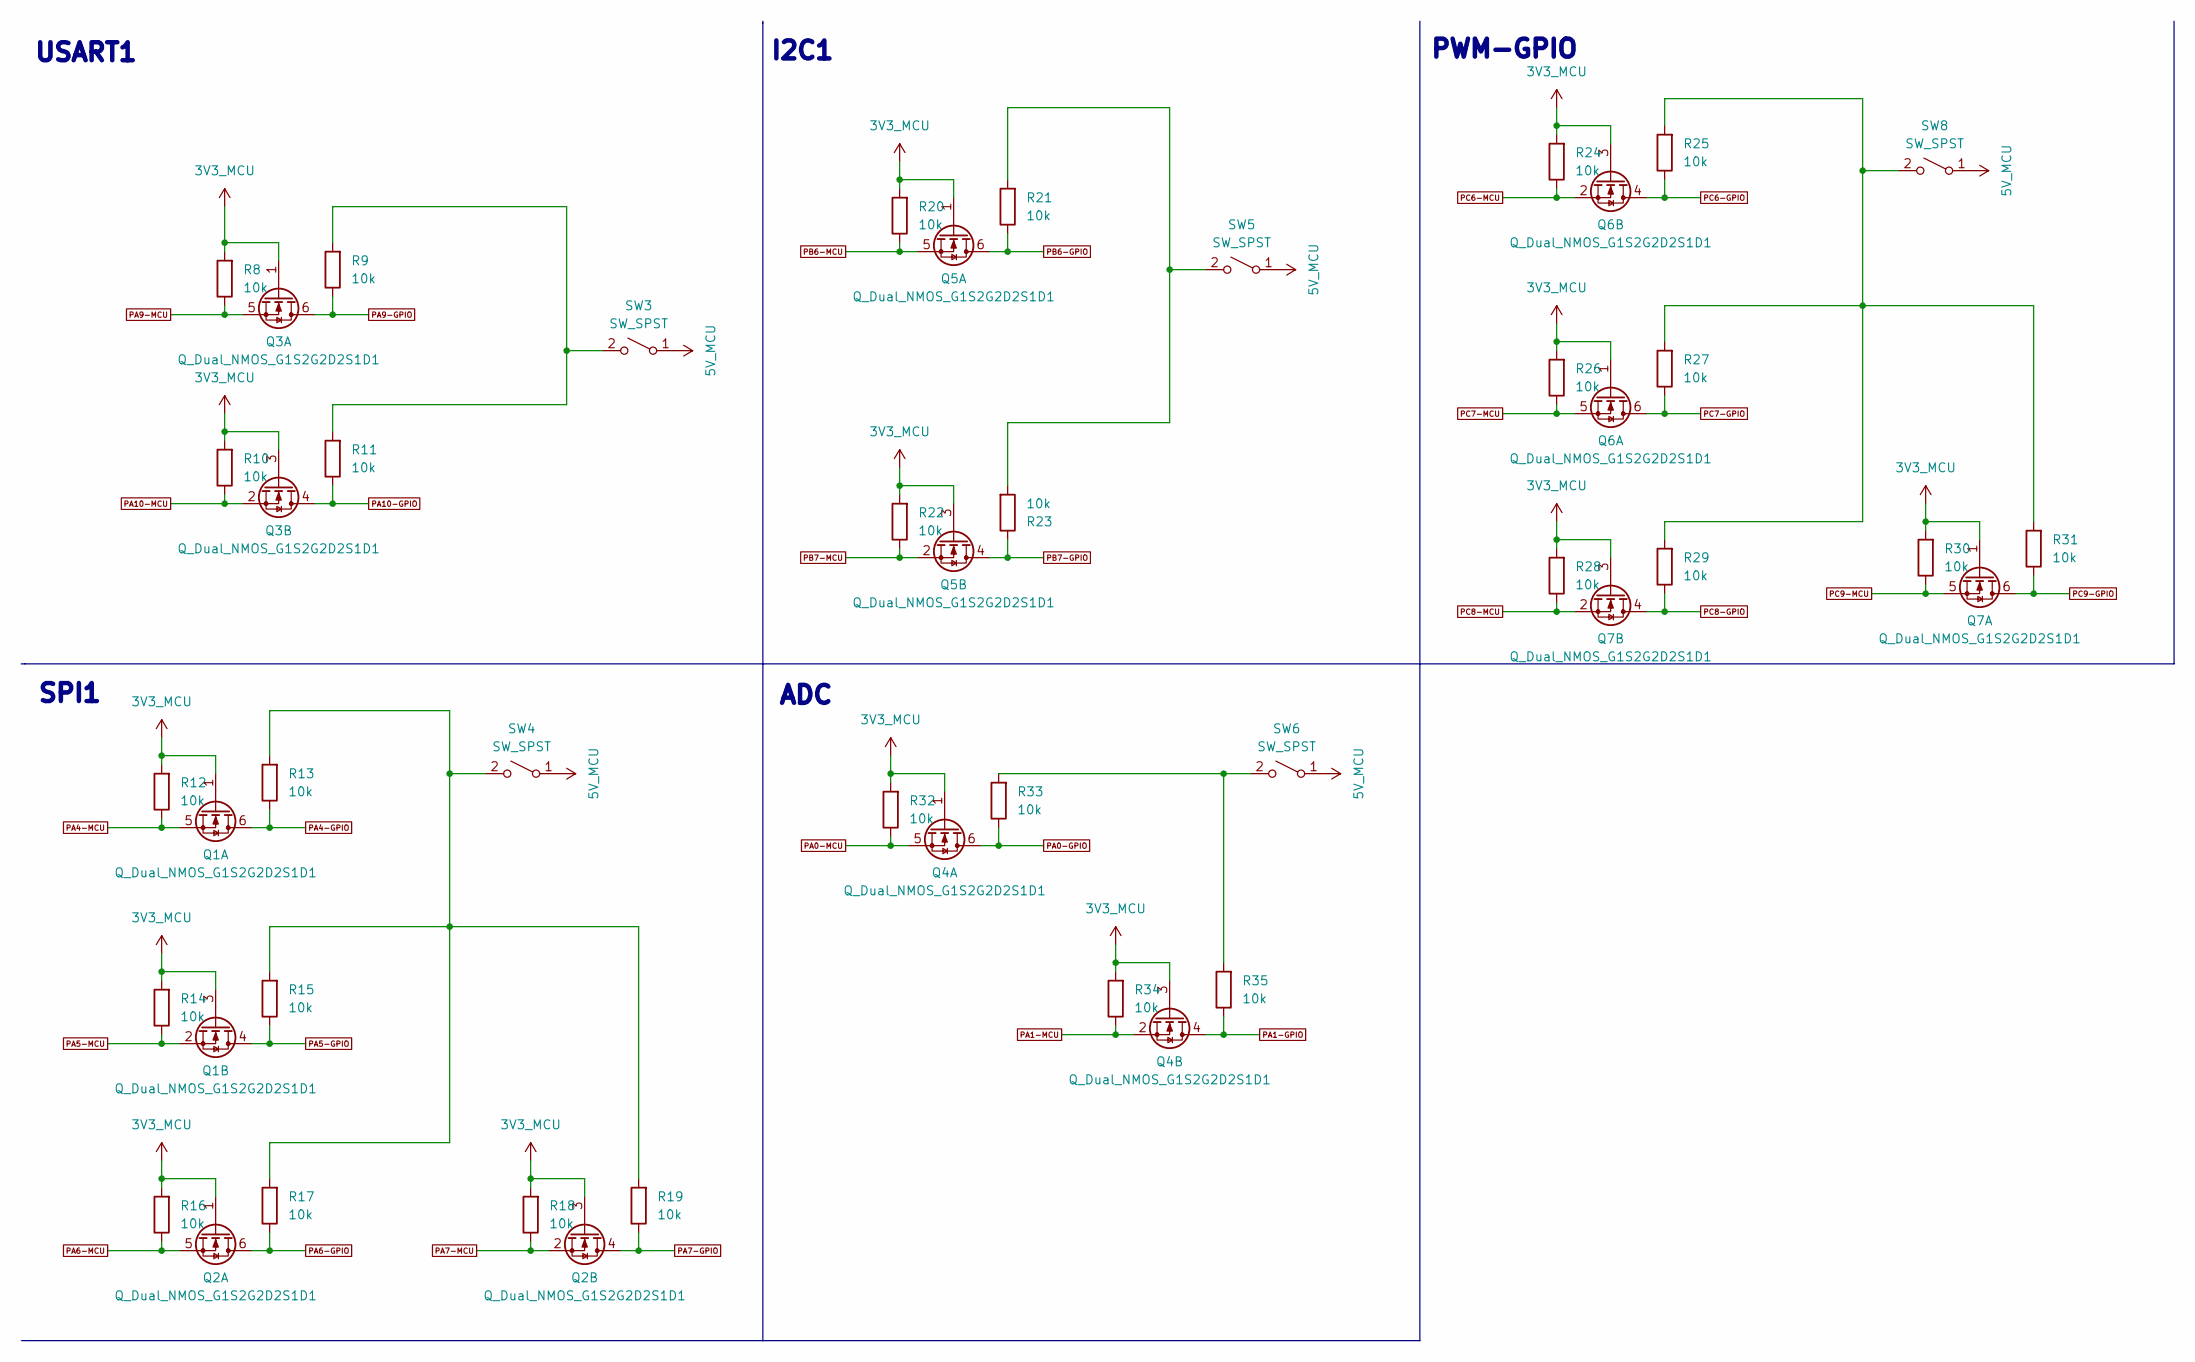
[picture p10: schematic MCU_level_shifters.kicad_sch]

Parts:
Q1, Q2, Q3, Q4, Q5, Q6, Q7: Q_Dual_NMOS_G1S2G2D2S1D1; SOT-23-6_Handsoldering; LCSC Part Number C404322
R8, R9, R10, R11, R12, R13, R14, R15, R16, R17, R18, R19, R20, R21, R22, R23, R24, R25, R26, R27, R28, R29, R30, R31, R32, R33, R34, R35: 10k; R_0603_1608Metric_Pad0.98x0.95mm_HandSolder; LCSC Part Number C98220
SW3, SW4, SW5, SW6, SW8: SW_SPST; SW_DIP_SPSTx01_Slide_9.78x4.72mm_W7.62mm_P2.54mm; LCSC Part Number C41381904

Connections:
3V3_MCU: Q1.1 (G), Q1.3 (G), Q2.1 (G), Q2.3 (G), Q3.1 (G), Q3.3 (G), Q4.1 (G), Q4.3 (G), Q5.1 (G), Q5.3 (G), Q6.1 (G), Q6.3 (G), Q7.1 (G), Q7.3 (G), R8.2, R10.2, R12.2, R14.2, R16.2, R18.2, R20.2, R22.2, R24.2, R26.2, R28.2, R30.2, R32.2, R34.2; also elsewhere on the board
5V_MCU: SW3.1 (A), SW4.1 (A), SW5.1 (A), SW6.1 (A), SW8.1 (A); also elsewhere on the board
unnamed: R9.2, R11.2, SW3.2 (B)
unnamed: R13.2, R15.2, R17.2, R19.2, SW4.2 (B)
unnamed: R21.2, R23.2, SW5.2 (B)
unnamed: R33.2, R35.2, SW6.2 (B)
unnamed: R25.2, R27.2, R29.2, R31.2, SW8.2 (B)
PA0-GPIO: Q4.6 (D), R33.1; also elsewhere on the board
PA0-MCU: Q4.5 (S), R32.1; also elsewhere on the board
PA1-GPIO: Q4.4 (D), R35.1; also elsewhere on the board
PA1-MCU: Q4.2 (S), R34.1; also elsewhere on the board
PA4-GPIO: Q1.6 (D), R13.1; also elsewhere on the board
PA4-MCU: Q1.5 (S), R12.1; also elsewhere on the board
PA5-GPIO: Q1.4 (D), R15.1; also elsewhere on the board
PA5-MCU: Q1.2 (S), R14.1; also elsewhere on the board
PA6-GPIO: Q2.6 (D), R17.1; also elsewhere on the board
PA6-MCU: Q2.5 (S), R16.1; also elsewhere on the board
PA7-GPIO: Q2.4 (D), R19.1; also elsewhere on the board
PA7-MCU: Q2.2 (S), R18.1; also elsewhere on the board
PA9-GPIO: Q3.6 (D), R9.1; also elsewhere on the board
PA9-MCU: Q3.5 (S), R8.1; also elsewhere on the board
PA10-GPIO: Q3.4 (D), R11.1; also elsewhere on the board
PA10-MCU: Q3.2 (S), R10.1; also elsewhere on the board
PB6-GPIO: Q5.6 (D), R21.1; also elsewhere on the board
PB6-MCU: Q5.5 (S), R20.1; also elsewhere on the board
PB7-GPIO: Q5.4 (D), R23.1; also elsewhere on the board
PB7-MCU: Q5.2 (S), R22.1; also elsewhere on the board
PC6-GPIO: Q6.4 (D), R25.1; also elsewhere on the board
PC6-MCU: Q6.2 (S), R24.1; also elsewhere on the board
PC7-GPIO: Q6.6 (D), R27.1; also elsewhere on the board
PC7-MCU: Q6.5 (S), R26.1; also elsewhere on the board
PC8-GPIO: Q7.4 (D), R29.1; also elsewhere on the board
PC8-MCU: Q7.2 (S), R28.1; also elsewhere on the board
PC9-GPIO: Q7.6 (D), R31.1; also elsewhere on the board
PC9-MCU: Q7.5 (S), R30.1; also elsewhere on the board

Notes on the sheet:
SPI1
PWM-GPIO
USART1
ADC
I2C1

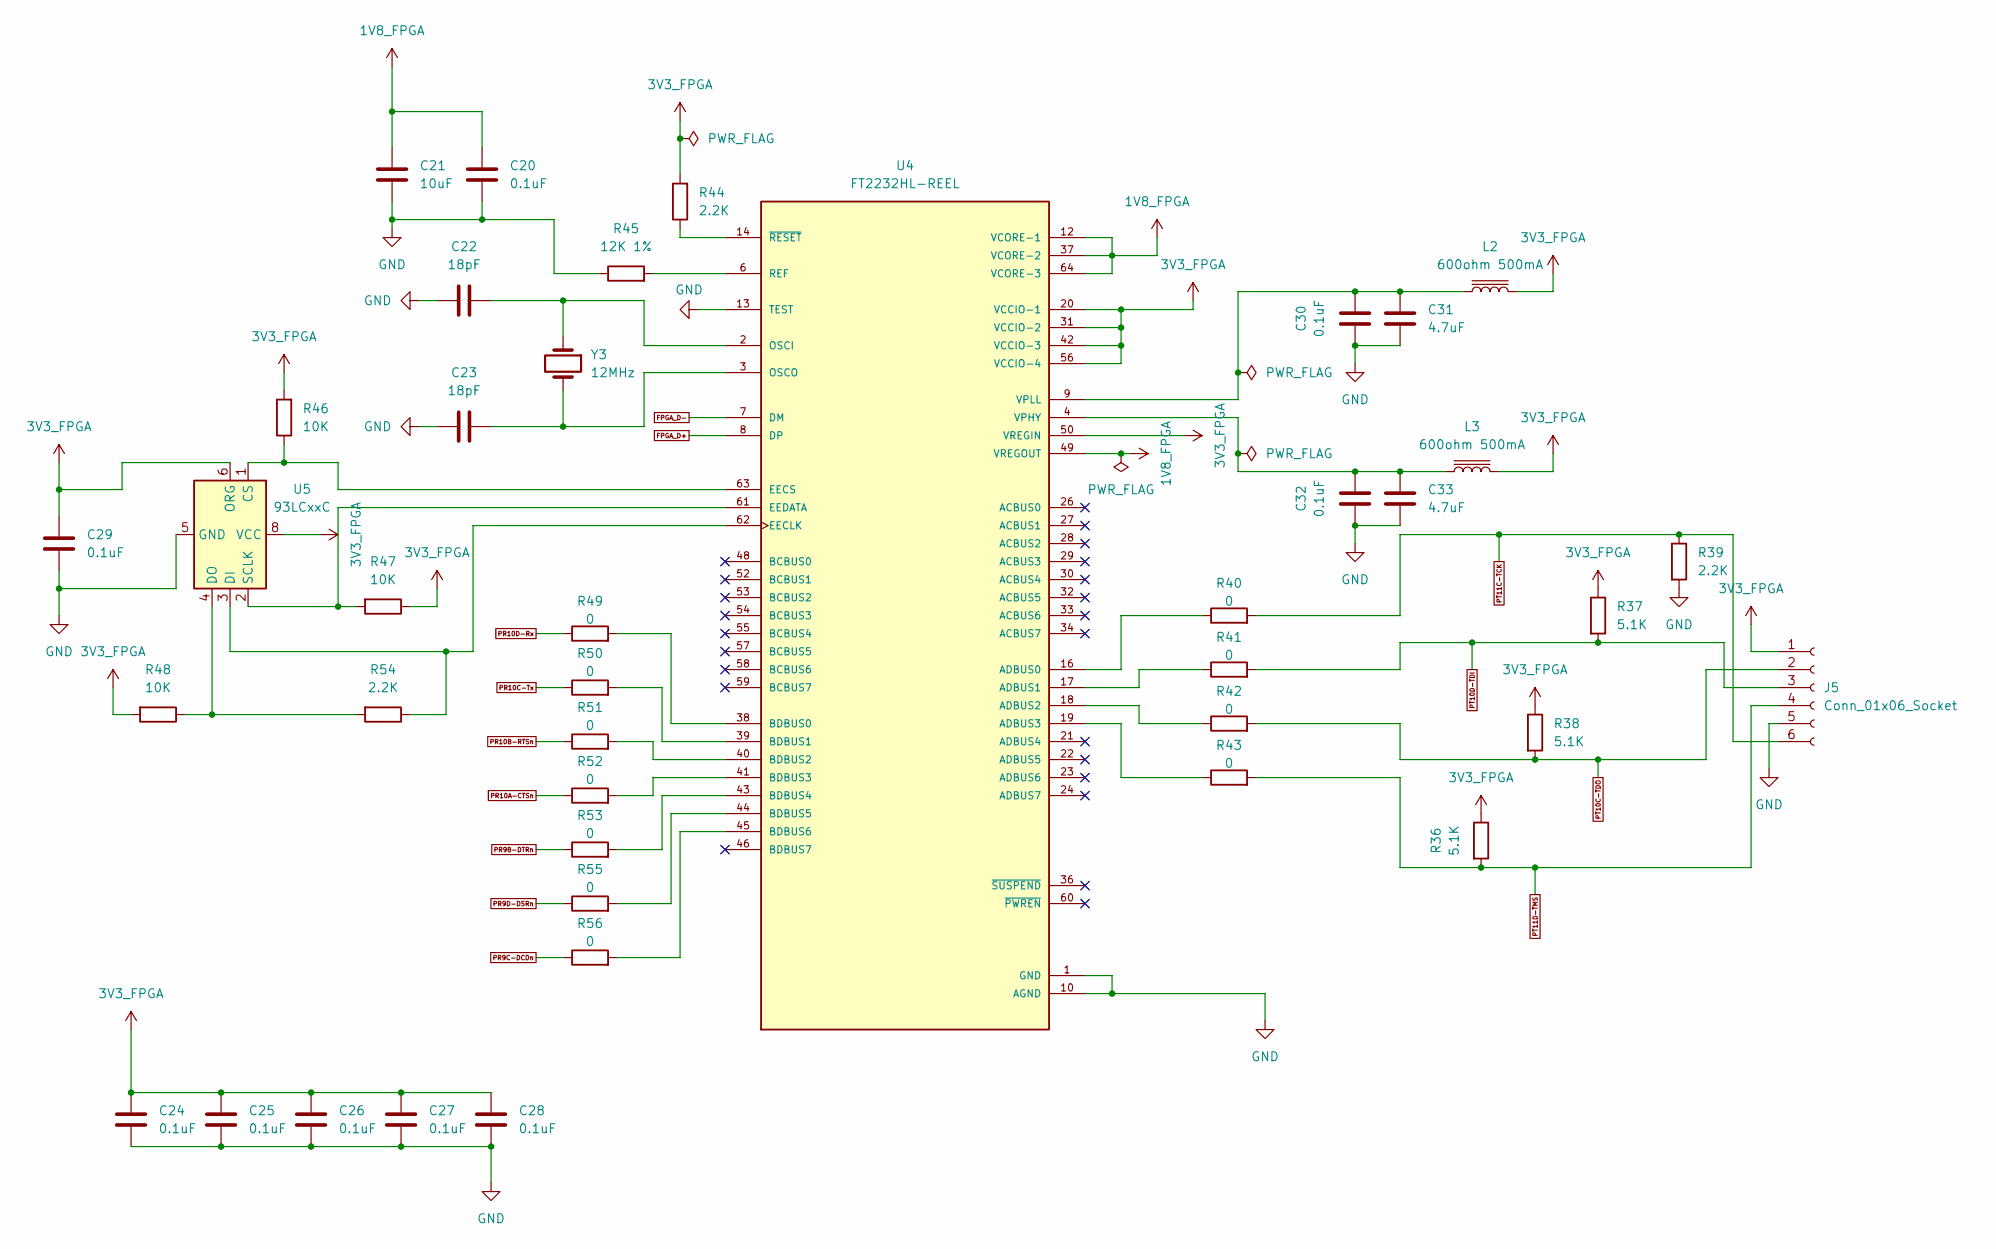
[picture p11: schematic FT2232HL.kicad_sch, IR-Multiboard/FPGA_FTDI]

Parts:
C20, C24, C25, C26, C27, C28, C29, C30, C32: 0.1uF; C_0603_1608Metric_Pad1.08x0.95mm_HandSolder; LCSC Part Number C14663
C21: 10uF; C_0603_1608Metric_Pad1.08x0.95mm_HandSolder; LCSC Part Number C19702
C22, C23: 18pF; C_0603_1608Metric_Pad1.08x0.95mm_HandSolder; LCSC Part Number C49326300
C31, C33: 4.7uF; C_0603_1608Metric_Pad1.08x0.95mm_HandSolder; LCSC Part Number C19666
J5: Conn_01x06_Socket; Hirose_DF13-06P-1.25DSA_1x06_P1.25mm_Vertical
L2, L3: 600ohm 500mA; L_0603_1608Metric_Pad1.05x0.95mm_HandSolder; LCSC Part Number C20345
R36, R37, R38: 5.1K; R_0603_1608Metric_Pad0.98x0.95mm_HandSolder; LCSC Part Number C2907044
R39, R44, R54: 2.2K; R_0603_1608Metric_Pad0.98x0.95mm_HandSolder; LCSC Part Number C114662
R40, R41, R42, R43, R49, R50, R51, R52, R53, R55, R56: 0; R_0603_1608Metric_Pad0.98x0.95mm_HandSolder; LCSC Part Number C95177
R45: 12K 1%; R_0603_1608Metric_Pad0.98x0.95mm_HandSolder; LCSC Part Number C431727
R46, R47, R48: 10K; R_0603_1608Metric_Pad0.98x0.95mm_HandSolder; LCSC Part Number C98220
U4: FT2232HL-REEL; QFP50P1200X1200X160-64N; LCSC Part Number C27882
U5: 93LCxxC; SO-8_3.9x4.9mm_P1.27mm; LCSC Part Number C1350395
Y3: 12MHz; Crystal_SMD_TXC_7A-2Pin_5x3.2mm

Connections:
1V8_FPGA: C20.1, C21.1, U4.12 (VCORE-1), U4.37 (VCORE-2), U4.49 (VREGOUT), U4.64 (VCORE-3)
3V3_FPGA: C24.1, C25.1, C26.1, C27.1, C28.1, C29.1, J5.1, L2.2, L3.2, R36.1, R37.1, R38.1, R44.2, R46.2, R47.1, R48.2, U4.20 (VCCIO-1), U4.31 (VCCIO-2), U4.42 (VCCIO-3), U4.50 (VREGIN), U4.56 (VCCIO-4), U5.6 (ORG), U5.8 (VCC); also elsewhere on the board
FPGA_D+: U4.8 (DP); also elsewhere on the board
FPGA_D-: U4.7 (DM); also elsewhere on the board
GND: C20.2, C21.2, C22.1, C23.2, C24.2, C25.2, C26.2, C27.2, C28.2, C29.2, C30.1, C31.1, C32.1, C33.1, J5.5, R39.2, R45.1, U4.1 (GND), U4.5 (GND), U4.10 (AGND), U4.11 (GND), U4.13 (TEST), U4.15 (GND), U4.25 (GND), U4.35 (GND), U4.47 (GND), U4.51 (GND), U5.5 (GND); also elsewhere on the board
unnamed: R40.1, U4.16 (ADBUS0)
unnamed: R41.1, U4.17 (ADBUS1)
unnamed: R42.1, U4.18 (ADBUS2)
unnamed: R43.1, U4.19 (ADBUS3)
unnamed: R49.2, U4.38 (BDBUS0)
unnamed: R50.2, U4.39 (BDBUS1)
unnamed: R51.2, U4.40 (BDBUS2)
unnamed: R52.2, U4.41 (BDBUS3)
unnamed: R53.2, U4.43 (BDBUS4)
unnamed: R55.2, U4.44 (BDBUS5)
unnamed: R56.2, U4.45 (BDBUS6)
unnamed: R54.1, U4.62 (EECLK), U5.3 (DI)
unnamed: R46.1, U4.63 (EECS), U5.1 (CS)
unnamed: R47.2, U4.61 (EEDATA), U5.2 (SCLK)
unnamed: C22.2, U4.2 (OSCI), Y3.1
unnamed: C23.1, U4.3 (OSCO), Y3.2
unnamed: R45.2, U4.6 (REF)
unnamed: C32.2, C33.2, L3.1, U4.4 (VPHY)
unnamed: C30.2, C31.2, L2.1, U4.9 (VPLL)
unnamed: R44.1, U4.14 (~RESET)
unnamed: R48.1, R54.2, U5.4 (DO)
PR9B-DTRn: R53.1; also elsewhere on the board
PR9C-DCDn: R56.1; also elsewhere on the board
PR9D-DSRn: R55.1; also elsewhere on the board
PR10A-CTSn: R52.1; also elsewhere on the board
PR10B-RTSn: R51.1; also elsewhere on the board
PR10C-Tx: R50.1; also elsewhere on the board
PR10D-Rx: R49.1; also elsewhere on the board
PT10C-TDO: J5.2, R38.2, R42.2; also elsewhere on the board
PT10D-TDI: J5.3, R37.2, R41.2; also elsewhere on the board
PT11C-TCK: J5.6, R39.1, R40.2; also elsewhere on the board
PT11D-TMS: J5.4, R36.2, R43.2; also elsewhere on the board

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
