Ivailo2707/Multiboard/Multiboard/Multiboard.kicad_pcb

## KiCad design Multiboard/Multiboard.kicad_pcb (continued)

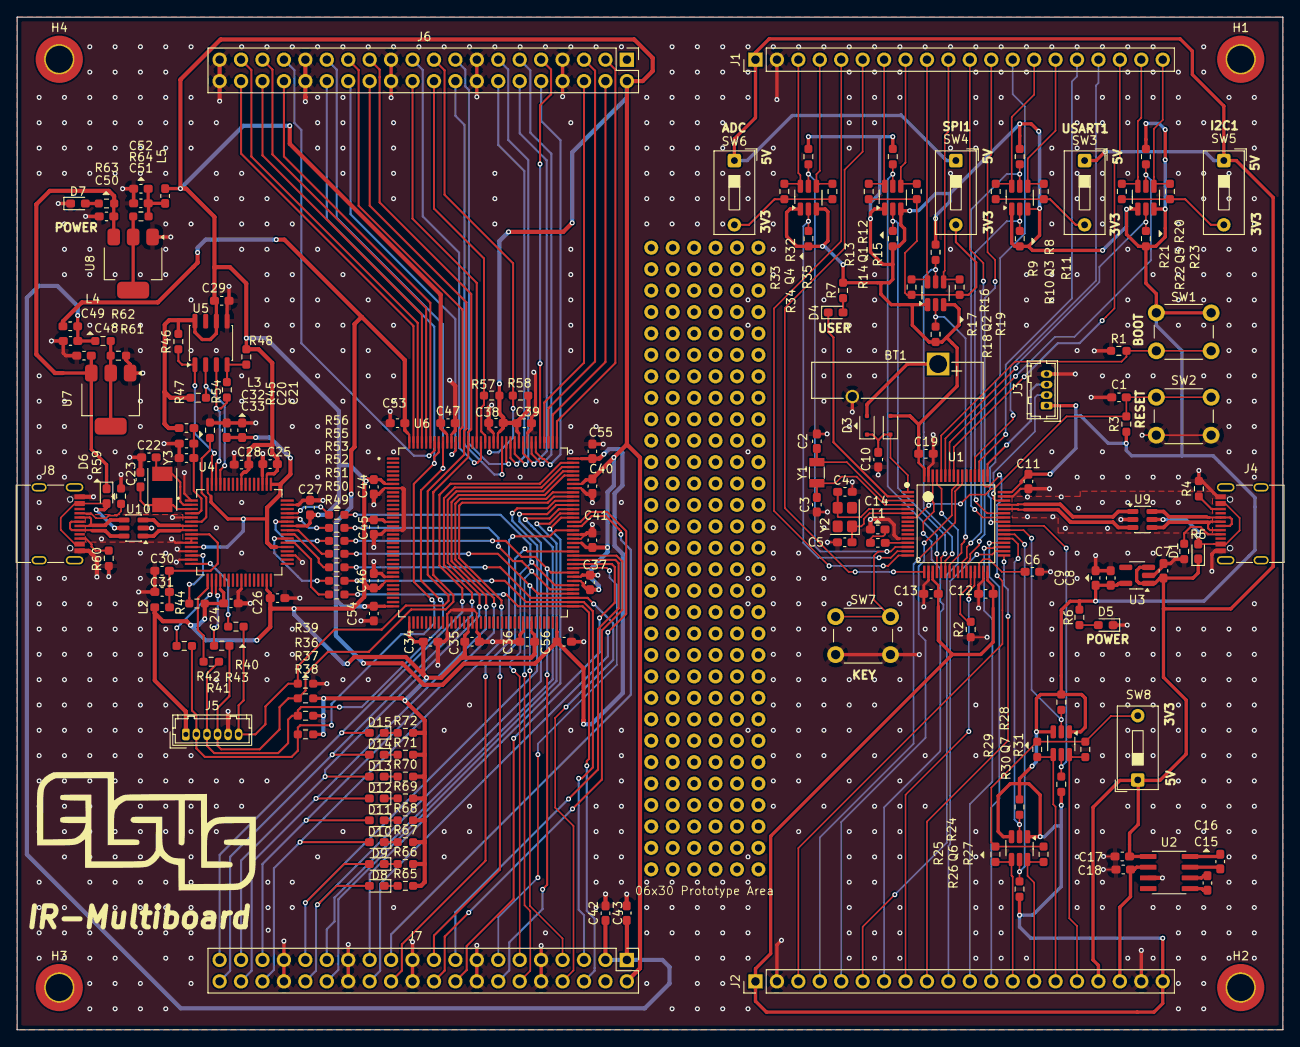
[picture p12: board Multiboard.kicad_pcb from above]

Board: 2 copper layers, 150.0 x 120.0 mm, 190 parts (0 on the bottom side), 178 nets.

Other parts of the board:
06x30 Prototype Area: 6x30
