Ivailo2707/Multiboard/(commit log)

2026-01-21 Started PCB work
    Positioned mounting holes, pins and MCU, wired boot, reset buttons and ADC shifters
    [MCU_level_shifters.kicad_sch, Multiboard.kicad_pcb, Multiboard.kicad_sch]
2026-01-21 FIxed level shifter implementation
    [MCU_level_shifters.kicad_sch, Multiboard.kicad_pcb, Multiboard.kicad_sch]
2026-01-21 Fixed bus implementation
    [MCU_level_shifters.kicad_sch, Multiboard.kicad_pcb, Multiboard.kicad_sch]
2026-01-22 changed mosfet footprint
    [MCU_level_shifters.kicad_sch, Multiboard.kicad_pcb]
2026-01-22 positioned and wired adc level shifter and decoupling capacitors
    [Multiboard.kicad_pcb]
2026-01-23 positioned USART1 and I2C1 level shifters
    [MCU_level_shifters.kicad_sch, Multiboard.kicad_pcb, Multiboard.kicad_sch]
2026-01-25 wired all level shifters and increased width of decoupling traces
    [Multiboard.kicad_pcb, Multiboard.kicad_sch]
2026-01-27 wired level shifters; positioed ldo and charge pump
    [MCU_level_shifters.kicad_sch, Multiboard.kicad_pcb, Multiboard.kicad_sch]
2026-01-31 positioned and wired ldo charge pump buttons leds and rtc circuit
    [Multiboard.kicad_pcb, Multiboard.kicad_sch]
2026-02-01 wired most of the gpio pins
    [Multiboard.kicad_pcb]
2026-02-05 Wired usb
    [FPGA.kicad_sch, MCU.kicad_sch, MCU_level_shifters.kicad_sch, Multiboard.kicad_pcb, Multiboard.kicad_sch, untitled.kicad_sch]
2026-02-09 Implemented FTDI in schematic
    [FPGA.kicad_sch, FT2232HL.kicad_sch, Multiboard.kicad_pcb, Multiboard.kicad_sch]
2026-02-09 added and wired banks to the fpga schematic
    [FPGA.kicad_sch, MCU.kicad_sch]
2026-02-10 completed v1 FPGA schematic
    [FPGA.kicad_sch, FT2232HL.kicad_sch, Multiboard.kicad_sch]
2026-02-12 Added footprints and fixed schematic
    [FPGA.kicad_sch, FT2232HL.kicad_sch, MCU.kicad_sch, Multiboard.kicad_pcb]
2026-02-12 glitched schematic
    [FPGA.kicad_sch]
2026-02-12 Completed mcu usb-c, mcu oscillators and mcu jtag pins
    [FPGA.kicad_sch, MCU.kicad_sch, MCU_level_shifters.kicad_sch, Multiboard.kicad_pcb]
2026-02-14 positioned fpga-usb
    [Multiboard.kicad_pcb]
2026-02-14 wired fpga usb
    [Multiboard.kicad_pcb]
2026-02-14 positioned and wired FTDI
    [FPGA.kicad_sch, MCU.kicad_sch, Multiboard.kicad_pcb]
2026-02-15 placed decoupling capacitors around fpga
    [FT2232HL.kicad_sch, Multiboard.kicad_pcb]
2026-02-15 synchronised sch and pcb. Added jtag connection between fpga and ftdi
    [FPGA.kicad_sch, FT2232HL.kicad_sch, MCU_level_shifters.kicad_sch]
2026-02-15 positioned ldo's and wired a few pins
    [FPGA.kicad_sch, Multiboard.kicad_pcb]
2026-02-16 finished wiring all components
    [Multiboard.kicad_pcb]
2026-02-16 test reverse polarity diode
2026-02-16 test reverse polarity
    [MCU.kicad_sch]
2026-02-16 wired power traces and added prototype area
    [FPGA.kicad_sch, MCU.kicad_sch, Multiboard.kicad_pcb]
2026-02-16 added copper zone on bot layer
    [Multiboard.kicad_pcb]
2026-02-19 fixed fpga header issue
    [FPGA.kicad_sch, MCU.kicad_sch, Multiboard.kicad_pcb, Multiboard.kicad_sch, untitled.kicad_sch]
2026-02-19 fixed switch and led issue
    [FPGA.kicad_sch]
2026-02-22 added silkscreen layer
2026-02-22 added elsys logo and project name to silkscreen
    [Multiboard.kicad_pcb, Multiboard.kicad_sch]
2026-02-23 fixed trace spacing issues in fpga pins
    [Multiboard.kicad_pcb]
2026-03-13 cleared part of errors and warnings
    [FPGA.kicad_sch, FT2232HL.kicad_sch, MCU.kicad_sch, MCU_level_shifters.kicad_sch, Multiboard.kicad_pcb, Multiboard.kicad_sch]
2026-03-14 cleared thermal relief and solder mask errors
    [Multiboard.kicad_pcb]
2026-03-16 added missing paths
    [Multiboard.kicad_pcb]
2026-03-18 fixed dead copper zones and cleared all errors
    [FPGA.kicad_sch, FT2232HL.kicad_sch, MCU.kicad_sch, MCU_level_shifters.kicad_sch, Multiboard.kicad_pcb]
2026-03-19 removed unused vias
    [Multiboard.kicad_pcb]
2026-03-20 added top layer copper zone with stitiching vias, fixed trace issues and changed mcu pins footprint
    [MCU.kicad_sch, Multiboard.kicad_pcb]
2026-03-24 fixed missing fpga pins and added dedicated usb protection ic instead of diodes
    [FPGA.kicad_sch, MCU.kicad_sch, Multiboard.kicad_pcb]
2026-03-30 Fixed trace angle
    [FPGA.kicad_sch, Multiboard.kicad_pcb]
2026-04-03 Generated BOM
    [FPGA.kicad_sch, FT2232HL.kicad_sch, MCU.kicad_sch, MCU_level_shifters.kicad_sch, Multiboard.kicad_pcb, Multiboard.kicad_sch]
2026-04-04 Added gbr drill bom and placement files
    [Multiboard.csv, Multiboard.kicad_pcb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]
2026-04-04 added pick and place file
    [Multiboard.csv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]
2026-04-06 fixed MCU LDO
    [FPGA.kicad_sch, MCU.kicad_sch, Multiboard.kicad_pcb]
2026-04-06 KiCAD glitch test
2026-04-07 Restored older version due to KiCAD glitching
    [FPGA.kicad_sch, FT2232HL.kicad_sch, MCU.kicad_sch, Multiboard.kicad_pcb]
2026-04-07 Fixed glitched nets issue
    [FPGA.kicad_sch, FT2232HL.kicad_sch, MCU.kicad_sch, Multiboard.kicad_pcb, Multiboard.kicad_sch]
2026-04-07 Added final gbr bom and P&P
    [Multiboard-bom.csv, Multiboard.csv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]
